newaetech/chipwhisperer-husky-fpga/README.md

# ChipWhisperer-Husky
This repository contains the FPGA design and test files for
ChipWhisperer-Husky and Husky-Plus.

# Documentation
All documentation is now on the associated
[readthedocs](https://chipwhisperer-husky-fpga.readthedocs.io) site.
