newaetech/chipwhisperer-husky-fpga/fpga/vivado/cw310/README.md

For exploring Husky on the much larger xc7k160tfbg676-1 FPGA, using the CW-310
Bergen board. Work in progress.
