newaetech/chipwhisperer-husky-fpga/docs/source/Testing/testing.md

# Overview

CW-Husky is tested in two ways:
1. [Verilog simulation](simulation)
2. [On-target testing](ontarget)
