newaetech/chipwhisperer-husky-fpga/(threads)

Thread 6 (2022-11-01):

Triggering glitch from SAD, UART, edge count, trace, or ADC level

jpcrypt, 2022-11-01:
When using the SAD, UART, edge count, trace, or ADC level as a trigger for glitching (i.e. `scope.glitch.trigger_src` is set to `ext_single` or `ext_continuous`), glitches are not always generated.

There are no known issues with triggering an **ADC capture** from these triggers - only in their use for glitching.

Credit to [Lennert Wouters](https://twitter.com/LennertWo) for finding the issue.

Closed 2022-11-05.

Thread 9 (2022-11-05):

Programmable pattern length for UART triggering.

jpcrypt, 2022-11-05:
The pattern length for UART (and trace) triggering is currently fixed at 8 bytes.
That is, if you set a pattern match as follows:
`scope.UARTTrigger.set_pattern_match(0, 'p00')`
then the trigger will not fire until Husky sees `p`, `0`, `0`, *and 5 more valid bytes* (which could be anything).
If Husky only sees `p00` followed by silence, then it won't trigger.
(Rationale: this made sense for trace since trace messages are always longer (if I remember correctly!))
For generic UART, it would be useful to  specify the pattern length; in the example above, if the length was set to 3, then Husky would fire a trigger immediately after seeing `p00`.

jpcrypt, 2023-01-31:
Important to note that the fix is not backwards compatible. The new default behaviour is that calling `set_pattern_match()` with a pattern shorter than 8 bytes will result in triggering immediately after the short pattern (instead of after the pattern + remaining bytes required to add up to 8 bytes).
If you were using something like `set_pattern_match(0, 'p00')` before and wish to retain the old behaviour, you'll need to change it to:
`set_pattern_match(0, 'p00xxxxx', [255,255,255,0,0,0,0,0])`.

Closed 2023-01-31.

Thread 16 (2023-07-28):

Capture triggering stuck

jpcrypt, 2023-07-28:
When multiple triggers are generated over the course of a capture (either from the target, or by a Husky trigger module like SAD), and `scope.adc.offset` is non-zero, unlucky combinations of ADC capture parameters and trigger events can result in the trigger module getting stuck: subsequent captures will fail with this message:

> (ChipWhisperer Scope WARNING|File _OpenADCInterface.py:623) Timeout in OpenADC capture(), no trigger seen! Trigger forced, data is invalid. Status: 10
WARNING:root:Timeout happened during capture

even though the trigger events are occurring. A full reset of Husky is then required to get functioning captures again.

Some conditions have to be met in order for the bug to pop up:
1. multiple triggers must occur during the capture of a *single* segment (e.g., `scope.adc.samples = X` and a trigger event occurs every < X samples This is not a normal setup for segmented capture.
2. `scope.adc.offset` must be greater than 0 (the greater it is, the more likely the bug will be triggered).
3. The ADC capture must finish in the window where a trigger has come in and the offset counter kicked off by that trigger has not reached `scope.adc.offset` yet.

This sounds complicated but what it boils down to is that you don't need to worry about this bug unless you have `scope.adc.segments=1`, `scope.adc.offset > 0`, and multiple trigger events during your capture, where the first trigger kicks off the capture and subsequent ones are ignored since `scope.adc.segments = 1`.

A fix is forthcoming.

jpcrypt, 2023-07-28:
Fixed by https://github.com/newaetech/chipwhisperer-husky-fpga/commit/c20c94b082bc7ecf07794f61588cc73470cedbcb

Closed 2023-07-28.

Thread 17 (2023-10-13):

Streaming can fail at low sampling rates

jpcrypt, 2023-10-13:
Streaming captures can fail with "slow FIFO underflow" and "fast FIFO overflow" errors when the sampling clock is < 10 MHz.

The failure occurs because the [Xilinx FIFO](https://github.com/newaetech/chipwhisperer-husky-fpga/tree/main/fpga/vivado/cwhusky.srcs/sources_1/ip/usb_slow_fifo)  (from which ADC samples are read) declares an underflow when it is actually nowhere near empty (internal FIFO read/write counters show that it's well over half full).

The reason *seems* to be that this FIFO was configured with a read clock of 96 MHz (which is accurate) and a write clock of 200 MHz (which is the fastest possible write clock, but could actually be as low as 5 MHz); it appears that the FIFO can misbehave when its read/write clock ratio is "too different" from what was specified.

A fix is in the works.

In the meantime there are workarounds:

- The simplest workaround is to simply increase the ADC sampling clock to 10 MHz or more. [Extensive testing](https://github.com/newaetech/chipwhisperer/blob/78fbca0326cb218c3e30ef11ff260aa1b01c9531/tests/test_husky.py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) has been done at those sampling rates; additionally, the [micro-ecc notebook series](https://github.com/newaetech/chipwhisperer-jupyter/tree/master/courses/sca205) does streaming captures at 10 MHz, and the [CW305 ECC series](https://github.com/newaetech/chipwhisperer-jupyter/tree/master/courses/sca204) uses 15 MHz.
- The next simplest  workaround is to increase the ADC sampling frequency by increasing `scope.clock.adc_mul`. This results in larger traces, but allows the target clock to stay the same.
- Another option involves tweaking the `scope.adc.stream_segment_size` and `scope.adc.stream_segment_threshold` parameters. These dictate the burst read size and default to 65536; reduce them (keeping both settings equal) until you get a clean capture. 8192 seems to work well with a sampling clock from 5 MHz to 9 MHz.

Closed 2023-10-16.
