newaetech/chipwhisperer-husky-fpga/fpga/hdl/fifo_top_husky_pro.v

`include "includes.v"
`timescale 1 ns / 1 ps
`default_nettype none

/***********************************************************************
This file is part of the ChipWhisperer Project. See www.newae.com for more
details, or the codebase at http://www.chipwhisperer.com
Built from fifo_top_husky.v and modified for Pro.

Copyright (c) 2021-2022, NewAE Technology Inc. All rights reserved.
Author: Jean-Pierre Thibault <jpthibault@newae.com>

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
  You should have received a copy of the GNU General Public License
  along with chipwhisperer.  If not, see <http://www.gnu.org/licenses/>.
*************************************************************************/

module fifo_top_husky_pro (
    input wire          reset,
    input wire          clk_usb,

    //ADC Sample Input
    input wire [11:0]   adc_datain,
    input wire          adc_sampleclk,
    input wire          capture_active, //for debug only
    input wire          capture_go,
    output reg          adc_capture_stop,
    input wire          arm_i,
    input wire          arm_usb,
    input wire [15:0]   num_segments,
    input wire [19:0]   segment_cycles,
    input wire          segment_cycle_counter_en,

    input wire  [14:0]  presample_i,
    input wire  [31:0]  max_samples_i,
    output wire [31:0]  max_samples_o,
    input wire  [12:0]  downsample_i, //Ignores this many samples inbetween captured measurements

    output wire         fifo_overflow, //If overflow happens (bad during stream mode)
    output reg          error_flag,
    output reg [13:0]   error_stat,
    output reg [13:0]   first_error_stat,
    output reg [2:0]    first_error_state,
    input  wire         clear_fifo_errors,
    input  wire         trigger_too_soon,
    input  wire         no_clip_errors,
    input  wire         no_gain_errors,
    output reg [7:0]    underflow_count,
    output reg          capture_done,
    output reg          armed_and_ready,
    output reg [2:0]    state,

    // to/from DDR:
    input  wire         ui_clk,
    output wire         capture_go_ui,
    output reg          write_done_out,
    input  wire         I_preddr_fifo_rd,
    output wire [63:0]  preddr_fifo_dout,
    output wire         preddr_fifo_empty,
    output reg          flushing,
    output wire         fast_fifo_empty,

    input  wire         postddr_fifo_empty,
    input  wire         postddr_fifo_overflow,
    input  wire         postddr_fifo_underflow_masked,
    input  wire         reading_too_soon_error,
    input  wire         ddr_full_error,

    output wire         arm_pulse_usb,

    input  wire         ddr_rwtest_en,

    input  wire         preddr_la_empty,
    input  wire         preddr_trace_empty,

    // for debug only:
    output reg          preddr_fifo_wr,
    output wire         preddr_fifo_underflow,
    output wire [7:0]   debug

);

    parameter pFIFO_FULL_SIZE = `MAX_SAMPLES;

    wire                fast_fifo_wr;
    reg                 fast_fifo_presample_drain;
    reg                 fast_fifo_rd_en = 1'b0;
    wire                fast_fifo_rd;
    wire [11:0]         fast_fifo_dout;
    wire                fast_fifo_full;
    wire                fast_fifo_overflow;
    wire                fast_fifo_underflow;

    reg                 preddr_fifo_rd_slow;
    wire                preddr_fifo_rd_fast;
    reg  [63:0]         preddr_fifo_din;
    wire                preddr_fifo_full;
    wire                preddr_fifo_overflow;

    reg                 fast_fifo_overflow_reg;
    reg                 preddr_fifo_overflow_reg;
    reg  [14:0]         presample_counter;
    reg  [31:0]         sample_counter;
    reg  [15:0]         segment_counter;
    reg  [19:0]         segment_cycle_counter;

    reg                 arm_r;
    wire                arm_pulse_adc;
    reg                 arming;
    reg                 capture_go_r;
    reg                 capture_go_r2;

    reg  [4:0]          done_wait_count;
    reg                 gain_error;
    reg                 segment_error;
    reg                 clip_error;
    reg                 gain_too_low;
    reg                 downsample_error;
    wire                clear_fifo_errors_adc;

    wire                write_done_ui;
    reg                 done_hold;

    assign fifo_overflow = fast_fifo_overflow_reg || preddr_fifo_overflow_reg;

    // make overflow sticky:
    always @(posedge adc_sampleclk) begin
       if (arm_pulse_adc || clear_fifo_errors_adc) begin
          fast_fifo_overflow_reg <= 1'b0;
          preddr_fifo_overflow_reg <= 1'b0;
       end
       else begin
          if (fast_fifo_overflow)
             fast_fifo_overflow_reg <= 1'b1;
          if (preddr_fifo_overflow)
             preddr_fifo_overflow_reg <= 1'b1;
       end
    end

    //Counter for downsampling (NOT proper decimation)
    reg [12:0] downsample_ctr;
    wire downsample_max;
    reg downsample_wr_en;

    assign downsample_max = (downsample_ctr == downsample_i) ? 1'b1 : 'b0;

    always @(posedge adc_sampleclk) begin
       if (arm_pulse_adc == 1'b1) begin
          downsample_ctr <= 13'd0;
          downsample_wr_en <= 1'b0;
       end 
       else begin
          // NOTE: capture_go_r* condition is to align downsample captures on
          // the trigger event. If downsample+presample support gets added,
          // this condition makes it possible to have two successive writes
          // that are very close together.
          if (downsample_max || (capture_go_r && ~capture_go_r2)) begin
             downsample_ctr <= 13'd0;
             downsample_wr_en <= 1'b1;
          end
          else begin
             downsample_ctr <= downsample_ctr + 13'd1;
             downsample_wr_en <= 1'b0;
          end
       end
    end

    assign max_samples_o = pFIFO_FULL_SIZE;


    // Presample logic: when armed, we always write to the fast FIFO. When
    // we reach the requested number of presamples, we start to also read
    // and discard, so as to keep exactly the requested number of presamples
    // in the fast FIFO. During this time, no data is sent to the slow FIFO.
    // When the trigger is received, the fast FIFO read data is then written
    // to the slow FIFO.

    localparam pS_IDLE = 0;
    localparam pS_PRESAMP_FILLING = 1;
    localparam pS_PRESAMP_FULL = 2;
    localparam pS_TRIGGERED = 3;
    localparam pS_SEGMENT_DONE = 4;
    localparam pS_DONE = 5;
    reg [2:0] state_r;

    // for easier debugging; also used by testbench:
    wire state_idle = (state == pS_IDLE);
    wire state_presamp_filling = (state == pS_PRESAMP_FILLING);
    wire state_presamp_full = (state == pS_PRESAMP_FULL);
    wire state_triggered = (state == pS_TRIGGERED);
    wire state_segment_done = (state == pS_SEGMENT_DONE);
    wire state_done = (state == pS_DONE);

    wire stop_capture_conditions;
    reg fsm_fast_wr_en;
    reg [19:0] segment_cycles_adjusted;

    assign stop_capture_conditions = arm_pulse_adc || adc_capture_stop;

    reg  presamp_done1_r;
    wire presamp_done1 = (capture_go && (segment_counter == 0));
    wire next_segment_go_pre = segment_cycle_counter_en?  ((segment_cycle_counter == segment_cycles_adjusted) && (segment_cycles > 0)) :
                                                          (capture_go && ~capture_go_r);

    wire presamp_done = presamp_done1_r || next_segment_go;
    wire presamp_error = presamp_done && (state == pS_PRESAMP_FILLING);

    reg next_segment_go;
    reg last_segment;
    reg last_sample;
    reg filler_read;
    // We're storing 12-bit samples into 64-bit words. If the number of samples is not a multiple of 
    // 16 (because 16 is the smallest number x such that x*12 is a number that can be divided by 64), 
    // then we need to execute dummy/filler ADC reads to fill out the last incomplete 64-bit word.
    wire [31:0] total_samples = max_samples_i * num_segments;
    wire filler_read_needed = (total_samples[3:0] != 4'b0000);

    always @(posedge adc_sampleclk) begin
        if (segment_cycles > 1) // alternatively, could do this in Python instead  (but why- everything works now)
            segment_cycles_adjusted <= segment_cycles - 2;
        else
            segment_cycles_adjusted <= segment_cycles;
        next_segment_go <= next_segment_go_pre; // this would add a cycle of latency but we've compensate by registering the ADC input in openadc_interface.v
        last_segment <= (segment_counter == (num_segments-1));
        if (downsample_i > 0)
            last_sample <= (sample_counter == (max_samples_i-1));
        else
            last_sample <= (sample_counter == (max_samples_i-2));
        presamp_done1_r <= presamp_done1;
    end

    always @ (posedge adc_sampleclk) begin
        if (reset) begin
            clip_error <= 1'b0;
            gain_too_low <= 1'b0;
            gain_error <= 1'b0;
        end
        else begin
            if (no_clip_errors || clear_fifo_errors_adc)
                clip_error <= 1'b0;
            //  TODO: just condition on "ADC fifo out when triggered" sort of thing
            else if (preddr_fifo_wr && (fast_fifo_dout[11:0]  == {12{1'b1}} || fast_fifo_dout[11:0]  == {12{1'b0}}) )
                clip_error <= 1'b1;

            if (no_gain_errors || clear_fifo_errors_adc)
                gain_too_low <= 1'b0;
            else if (capture_go)
                gain_too_low <= 1'b1;
            else if (preddr_fifo_wr && (fast_fifo_dout[11]? fast_fifo_dout[10:9]  != 2'b00 : fast_fifo_dout[10:8]  != 3'b111) )
                gain_too_low <= 1'b0;

            if (no_gain_errors || clear_fifo_errors_adc)
                gain_error <= 1'b0;
            else if ((state == pS_IDLE) && (state_r == pS_DONE) && gain_too_low)
                gain_error <= 1'b1;
        end
    end

    always @ (posedge adc_sampleclk) begin
       if (reset) begin
          state <= pS_IDLE;
          presample_counter <= 0;
          sample_counter <= 0;
          fast_fifo_presample_drain <= 1'b0;
          adc_capture_stop <= 1'b0;
          fast_fifo_rd_en <= 1'b0;
          segment_counter <= 0;
          segment_cycle_counter <= 0;
          downsample_error <= 1'b0;
          segment_error <= 1'b0;
          filler_read <= 1'b0;
       end

       else begin
          state_r <= state;
          case (state)

             pS_IDLE: begin
                presample_counter <= 0;
                sample_counter <= 0;
                fast_fifo_presample_drain <= 1'b0;
                adc_capture_stop <= 1'b0;
                fast_fifo_rd_en <= 1'b0;
                segment_counter <= 0;
                segment_cycle_counter <= 0;
                segment_error <= 1'b0;
                fsm_fast_wr_en <= 1'b0;
                filler_read <= 1'b0;
                done_wait_count <= 0;

                if ((downsample_i > 0) && ((presample_i > 0) || (num_segments > 1)))
                   downsample_error <= 1'b1;
                else
                   downsample_error <= 1'b0;

                if (armed_and_ready && ~adc_capture_stop && ~ddr_rwtest_en) begin
                   if (presample_i > 0) begin
                      fsm_fast_wr_en <= 1'b1;
                      state <= pS_PRESAMP_FILLING;
                   end
                   else if (capture_go_r) begin
                      fsm_fast_wr_en <= 1'b1;
                      state <= pS_TRIGGERED;
                   end
                end
             end

             pS_PRESAMP_FILLING: begin
                fast_fifo_presample_drain <= 1'b0;
                if (next_segment_go && (state_r == pS_PRESAMP_FILLING))
                   segment_error <= 1'b1;
                if (segment_counter > 0)
                   segment_cycle_counter <= segment_cycle_counter + 1;
                if (stop_capture_conditions) begin
                   fsm_fast_wr_en <= 1'b0;
                   state <= pS_DONE;
                end
                else if (presamp_done) begin
                   state <= pS_TRIGGERED;
                end
                else if (presample_counter == (presample_i-2)) begin
                   state <= pS_PRESAMP_FULL;
                end
                else if (fast_fifo_wr) begin
                   presample_counter <= presample_counter + 1;
                end
             end

             pS_PRESAMP_FULL: begin
                if (segment_counter > 0)
                   segment_cycle_counter <= segment_cycle_counter + 1;
                if (stop_capture_conditions) begin
                   fsm_fast_wr_en <= 1'b0;
                   state <= pS_DONE;
                end
                else if (presamp_done) begin
                   segment_cycle_counter <= 0;
                   sample_counter <= {17'b0, presample_i};
                   state <= pS_TRIGGERED;
                end
                if (fast_fifo_wr)
                   fast_fifo_presample_drain <= 1'b1;
                else
                   fast_fifo_presample_drain <= 1'b0;
             end

             pS_TRIGGERED: begin
                if (next_segment_go && (state_r == pS_TRIGGERED))
                   segment_error <= 1'b1;
                fast_fifo_presample_drain <= 1'b0;
                fast_fifo_rd_en <= 1'b1;
                segment_cycle_counter <= segment_cycle_counter + 1;

                if (stop_capture_conditions || (last_sample && fast_fifo_wr && last_segment)) begin
                   adc_capture_stop <= 1'b1;
                   done_wait_count <= 20;  // established by trial/error to account for the latency in the Xilinx FIFO updating its empty flag
                                           // plus extra cycles to execute filler_read (to generate the last 64-bit word)
                                           // TODO: update to 20 for Pro needs to be more carefully checked; it was chosen because it looked like
                                           // it should work.
                   fsm_fast_wr_en <= 1'b0;
                   state <= pS_DONE;
                end

                else if (last_sample && ~last_segment && fast_fifo_wr) begin
                   fsm_fast_wr_en <= 1'b0;
                   state <= pS_SEGMENT_DONE;
                end

                if (fast_fifo_wr) begin
                   sample_counter <= sample_counter + 1;
                end
             end

             pS_SEGMENT_DONE: begin
                segment_cycle_counter <= segment_cycle_counter + 1;
                if (fast_fifo_empty) begin
                   fast_fifo_rd_en <= 1'b0;
                   if (presample_i > 0) begin
                      segment_counter <= segment_counter + 1;
                      sample_counter <= 0;
                      presample_counter <= 0;
                      fsm_fast_wr_en <= 1'b1;
                      state <= pS_PRESAMP_FILLING;
                   end
                   else if (next_segment_go) begin
                      segment_counter <= segment_counter + 1;
                      segment_cycle_counter <= 0;
                      sample_counter <= 0;
                      fsm_fast_wr_en <= 1'b1;
                      state <= pS_TRIGGERED;
                   end
                end
                else if (next_segment_go) begin
                   segment_error <= 1'b1;
                   state <= pS_IDLE;
                end
             end

             pS_DONE: begin
                // serves three purposes:
                // 1. wait for fast FIFO to empty;
                // 2. generate "filler reads" so that the last full 64-bit word of ADC samples can be formed
                // 3. wait state so that we don't get back out of idle right away
                if ((fast_fifo_empty && (done_wait_count == 0)) || arm_i) begin
                   fast_fifo_rd_en <= 1'b0;
                   state <= pS_IDLE;
                end
                else if (fast_fifo_empty && (~preddr_fifo_full || filler_read))
                   // logic for the filler_read condition above is that when we start the filler reads,
                   // we know there will be only a single preddr FIFO write and so we no longer need to check on
                   // it being full
                   done_wait_count <= done_wait_count - 1;

                if (filler_read_needed && (done_wait_count < 6)) // TODO: "5" is just a placeholder; need to calculate correct value here!
                   filler_read <= 1'b1;

             end

          endcase
       end
    end

    always @(posedge adc_sampleclk) begin
       if (arm_pulse_adc)
          capture_done <= 1'b0;
       else if (state == pS_DONE)
          capture_done <= 1'b1;
    end


   wire clear_fifo_errors_r2;
   assign clear_fifo_errors_adc = clear_fifo_errors_r2;
   cdc_simple U_clear_fifo_errors_cdc (
       .reset          (reset),
       .clk            (adc_sampleclk),
       .data_in        (clear_fifo_errors),
       .data_out       (),
       .data_out_r     (clear_fifo_errors_r2)
   );

   wire flushing_adc;
   cdc_simple U_flushing_adc_cdc (
       .reset          (reset),
       .clk            (adc_sampleclk),
       .data_in        (flushing),
       .data_out       (flushing_adc),
       .data_out_r     ()
   );

   wire flushing_adc_usb;
   cdc_simple U_flushing_adc_usb_cdc (
       .reset          (reset),
       .clk            (clk_usb),
       .data_in        (flushing_adc),
       .data_out       (flushing_adc_usb),
       .data_out_r     ()
   );

   wire flushing_ui_usb;
   cdc_simple U_flushing_ui_usb_cdc (
       .reset          (reset),
       .clk            (clk_usb),
       .data_in        (flushing_ui),
       .data_out       (flushing_ui_usb),
       .data_out_r     ()
   );



    always @(posedge adc_sampleclk) begin
       if (reset) begin
          arming <= 1'b0;
          armed_and_ready <= 1'b0;
          capture_go_r <= 1'b0;
          capture_go_r2 <= 1'b0;
       end
       else begin
          capture_go_r <= capture_go;
          capture_go_r2 <= capture_go_r;
          arm_r <= arm_i;
          if (arm_i && ~arm_r && ~arming) begin
             arming <= 1'b1;
             armed_and_ready <= 1'b0;
          end
          else if (arming && ~flushing_adc) begin       // Thread carefully with this logic; the risk is that flushing_adc hasn't gone high yet
                                                        // before this condition is satisfied (and hence flushing hasn't even begun. Two clock
                                                        // domains are involved so exsercise caution.
             arming <= 1'b0;
             armed_and_ready <= 1'b1;
          end
          else if (adc_capture_stop)
             armed_and_ready <= 1'b0;
       end
    end

    assign fast_fifo_wr = downsample_wr_en & fsm_fast_wr_en & ~flushing_adc;

    // FIFO flushing mechanism: kick off flushing all FIFOs when arming.
    // Controlled from USB clock domain since that's closest to the ARM event,
    // and FIFOs use all the clocks anyways. Complicated only by all the
    // clocks.

    wire fast_fifo_empty_usb;
    cdc_simple U_fast_fifo_empty_cdc (
        .reset          (reset),
        .clk            (clk_usb),
        .data_in        (fast_fifo_empty),
        .data_out       (fast_fifo_empty_usb),
        .data_out_r     ()
    );

    // TODO: not needed?
    wire all_preddr_fifo_empty_usb;
    cdc_simple U_all_preddr_fifo_empty_cdc (
        .reset          (reset),
        .clk            (clk_usb),
        .data_in        (all_preddr_fifo_empty),
        .data_out       (all_preddr_fifo_empty_usb),
        .data_out_r     ()
    );

    // NOTE: the FIFO flush from arming the scope does not connect to the LA or trace preddr FIFOs, since trace and LA
    // have their own arming mechanisms; this *should* be fine since their preddr FIFOs will report "empty" when not enabled.
    // NOTE2: this would cause DUT to hang-up if an ADC job comes in when LA
    // job has already begun (thanks cocotb!). I think it's fine to just
    // remove it, but leaving these notes in case this somehow causes an
    // issue, for some reason I can't think of right now... TODO: eventually
    // clean up!
    wire all_preddr_fifo_empty = preddr_fifo_empty && preddr_la_empty && preddr_trace_empty;

    reg arm_usb_r;
    assign arm_pulse_usb = arm_usb && ~arm_usb_r;
    always @(posedge clk_usb) begin
        if (reset) begin
            flushing <= 1'b0;
            arm_usb_r <= 1'b0;
        end
        else begin
            arm_usb_r <= arm_usb;
            if (arm_pulse_usb)
                flushing <= 1'b1;
            //else if (fast_fifo_empty_usb && all_preddr_fifo_empty_usb && postddr_fifo_empty)
            // last two conditions are to ensure that CDC from flushing to flushing_adc and flushing_ui had a chance to occur:
            else if (fast_fifo_empty_usb && postddr_fifo_empty && flushing_adc_usb && flushing_ui_usb)
                flushing <= 1'b0;
        end
    end

    cdc_pulse U_fifo_rst_start_cdc (
       .reset_i       (reset),
       .src_clk       (clk_usb),
       .src_pulse     (arm_pulse_usb),
       .dst_clk       (adc_sampleclk),
       .dst_pulse     (arm_pulse_adc)
    );

    wire flushing_ui;
    cdc_simple U_flushing_ui_cdc (
        .reset          (reset),
        .clk            (ui_clk),
        .data_in        (flushing),
        .data_out       (flushing_ui),
        .data_out_r     ()
    );


    wire postddr_fifo_underflow_masked_adc;
    cdc_simple U_slow_fifo_underflow_masked_cdc (
        .reset          (reset),
        .clk            (clk_usb),
        .data_in        (postddr_fifo_underflow_masked),
        .data_out       (postddr_fifo_underflow_masked_adc),
        .data_out_r     ()
    );

    // this may seem awkward; goal is to set new error bits without clearing old ones
    function [13:0] error_bits (input [13:0] current_error);
       begin
          error_bits = current_error;
          if (ddr_full_error)                error_bits[13] = 1'b1;
          if (reading_too_soon_error)        error_bits[12] = 1'b1;
          if (preddr_fifo_overflow)          error_bits[11] = 1'b1;
          if (preddr_fifo_underflow)         error_bits[10] = 1'b1;
          if (trigger_too_soon)              error_bits[9]  = 1'b1;
          if (gain_error)                    error_bits[8]  = 1'b1;
          if (segment_error)                 error_bits[7]  = 1'b1;
          if (downsample_error)              error_bits[6]  = 1'b1;
          if (clip_error)                    error_bits[5]  = 1'b1;
          if (presamp_error)                 error_bits[4]  = 1'b1;
          if (fast_fifo_overflow)            error_bits[3]  = 1'b1;
          if (fast_fifo_underflow)           error_bits[2]  = 1'b1;
          if (postddr_fifo_overflow)         error_bits[1]  = 1'b1;
          if (postddr_fifo_underflow_masked_adc) error_bits[0]  = 1'b1;
       end
    endfunction

    always @(posedge adc_sampleclk) begin
       if (reset) begin
          error_flag <= 0;
          error_stat <= 0;
          first_error_stat <= 0;
          underflow_count <= 0;
          first_error_state <= pS_IDLE;
       end
       else begin
          if (arm_pulse_adc || clear_fifo_errors) begin
             error_stat <= 0;
             first_error_stat <= 0;
             error_flag <= 0;
             underflow_count <= 0;
             first_error_state <= pS_IDLE;
          end
          else begin
             if (gain_error || segment_error || downsample_error || clip_error || presamp_error || 
                 fast_fifo_overflow || fast_fifo_underflow || postddr_fifo_overflow || postddr_fifo_underflow_masked_adc || 
                 preddr_fifo_overflow || preddr_fifo_underflow || reading_too_soon_error || ddr_full_error) begin
                error_flag <= 1;
                if (!error_flag) begin
                   first_error_stat <= error_bits(first_error_stat);
                   first_error_state <= state_r;
                end
             end

             error_stat <= error_bits(error_stat);

             if (postddr_fifo_underflow_masked_adc && (underflow_count != 8'hFF))
                underflow_count <= underflow_count + 1;
          end
       end
    end


    // Assemble 64-bit words from 12-bit samples to feed DDR.
    // Ideally we'd handle this with an asymetric+asynchronous FIFO, but Xilinx's simulation
    // model for such FIFOs doesn't simulate with iVerilog :-(
    // So this is the width conversion stage, which is followed by an asynchronous FIFO.
    // *must* be able to push one sample per cycle, to keep up.
    // But if decimation is used, then data will come in slower; must accomodate that too.
    // Word 1: 6 sample reads; 5x12, 4
    // Word 2: 5 sample reads; 8, 4x12, 8
    // Word 3: 5 sample reads; 4, 5x12
    // then start over...
    reg [1:0] wide_word_count;
    reg wide_word_valid;
    reg [71:0] wide_word_shifter;
    reg [2:0] adc_sample_counter;

    always @(posedge adc_sampleclk) begin
        if (reset) begin
            wide_word_count <= 0;
            wide_word_valid <= 0;
            wide_word_shifter <= 0;
            adc_sample_counter <= 0;
            preddr_fifo_din <= 0;
            preddr_fifo_wr <= 0;
            filler_write <= 0;
        end
        else begin
            preddr_fifo_wr <= wide_word_valid;
            filler_write <= wide_word_valid && filler_read;
            if (state == pS_IDLE) begin
                wide_word_count <= 0;
                wide_word_valid <= 0;
                wide_word_shifter <= 0;
                adc_sample_counter <= 0;
            end
            else if ((fast_fifo_rd || filler_read) && (state != pS_PRESAMP_FILLING) && (state != pS_PRESAMP_FULL)) begin
                wide_word_shifter <= {wide_word_shifter[59:0], fast_fifo_dout};
                if ( ((wide_word_count == 0) && (adc_sample_counter == 5)) ||
                     ((wide_word_count == 1) && (adc_sample_counter == 4)) ||
                     ((wide_word_count == 2) && (adc_sample_counter == 4)) ) begin
                    wide_word_valid <= 1'b1;
                    adc_sample_counter <= 0;
                    if (wide_word_count < 2)
                        wide_word_count <= wide_word_count + 1;
                    else
                        wide_word_count <= 0;
                end
                else begin
                    wide_word_valid <= 0;
                    adc_sample_counter <= adc_sample_counter + 1;
                end
            end
            else if (~filler_read)
                wide_word_valid <= 0;

            if (wide_word_valid)
                preddr_fifo_din <= (wide_word_count == 1)? wide_word_shifter[71:8] :
                                   (wide_word_count == 2)? wide_word_shifter[67:4] :
                                                           wide_word_shifter[63:0] ;
        end
    end

    reg filler_write;
    reg  write_done_adc;

    always @ (*) begin
        if (filler_read_needed)
            write_done_adc = filler_write;
        else
            write_done_adc = (state == pS_IDLE) && (state_r == pS_DONE);
    end

    cdc_pulse U_write_done_cdc (
       .reset_i       (reset),
       .src_clk       (adc_sampleclk),
       .src_pulse     (write_done_adc),
       .dst_clk       (ui_clk),
       .dst_pulse     (write_done_ui)
    );

    cdc_pulse U_capture_go_cdc (
       .reset_i       (reset),
       .src_clk       (adc_sampleclk),
       .src_pulse     (capture_go_r && ~capture_go_r2),
       .dst_clk       (ui_clk),
       .dst_pulse     (capture_go_ui)
    );

    always @(posedge ui_clk) begin
        if (reset) begin
            done_hold <= 1'b0;
            write_done_out <= 1'b0;
        end
        else begin
            // The write_done pulse activates a hold signal; then when the FIFO
            // goes empty, we know we are done:
            if (write_done_ui)
                done_hold <= 1'b1;
            else if (write_done_out)
                write_done_out <= 1'b0;
            else if (done_hold && preddr_fifo_empty) begin
                write_done_out <= 1'b1;
                done_hold <= 1'b0;
            end
        end
    end

    assign fast_fifo_rd = fast_fifo_presample_drain || 
                          (fast_fifo_rd_en && !preddr_fifo_full && !fast_fifo_empty) || 
                          (flushing_adc && !fast_fifo_empty);

    wire preddr_fifo_rd = I_preddr_fifo_rd || (flushing_ui && !preddr_fifo_empty);


    `ifdef NOXILINXFIFO
        `ifdef TINYFIFO
            // Note: can't use pBRAM on U_adc_fast_fifo because it would lead
            // to writing and reading the same memory location simultaneously.
            // This could be addressed by changing the FSM R/W timings.
            fifo_sync #(
                .pDATA_WIDTH    (12),
                .pDEPTH         (1024),
                .pFALLTHROUGH   (1),
                .pFLOPS         (0),
                .pDISTRIBUTED   (1),
                .pBRAM          (0)
            ) U_adc_fast_fifo (
                .clk            (adc_sampleclk),
                .rst_n          (~reset),
                .full_threshold_value (0),
                .empty_threshold_value (0),
                .wen            (fast_fifo_wr),
                .wdata          (adc_datain),
                .full           (fast_fifo_full),
                .overflow       (fast_fifo_overflow),
                .full_threshold (),
                .empty_threshold(),
                .ren            (fast_fifo_rd),
                .rdata          (fast_fifo_dout),
                .empty          (fast_fifo_empty),
                .almost_empty   (),
                .almost_full    (),
                .underflow      (fast_fifo_underflow)
            );
        `else
            fifo_sync #(
                .pDATA_WIDTH    (12),
                .pDEPTH         (32768),
                .pFALLTHROUGH   (1),
                .pFLOPS         (0),
                .pDISTRIBUTED   (1),
                .pBRAM          (0)
            ) U_adc_fast_fifo (
                .clk            (adc_sampleclk),
                .rst_n          (~reset),
                .full_threshold_value (0),
                .empty_threshold_value (0),
                .wen            (fast_fifo_wr),
                .wdata          (adc_datain),
                .full           (fast_fifo_full),
                .overflow       (fast_fifo_overflow),
                .full_threshold (),
                .empty_threshold(),
                .ren            (fast_fifo_rd),
                .rdata          (fast_fifo_dout),
                .empty          (fast_fifo_empty),
                .almost_empty   (),
                .almost_full    (),
                .underflow      (fast_fifo_underflow)
            );
        `endif
        fifo_async #(
            .pDATA_WIDTH    (64),
            .pDEPTH         (512),
            .pFALLTHROUGH   (0),
            .pFLOPS         (0),
            .pDISTRIBUTED   (0),
            .pBRAM          (1)
        ) U_pre_ddr_slow_fifo (
            .wclk                   (adc_sampleclk),
            .rclk                   (ui_clk),
            .wrst_n                 (~reset),
            .rrst_n                 (~reset),
            .wfull_threshold_value  (0),
            .rempty_threshold_value (0),
            .wen                    (preddr_fifo_wr),
            .wdata                  (preddr_fifo_din),
            .wfull                  (preddr_fifo_full),
            .walmost_full           (),
            .woverflow              (preddr_fifo_overflow),
            .wfull_threshold        (),
            .ren                    (preddr_fifo_rd),
            .rdata                  (preddr_fifo_dout),
            .rempty                 (preddr_fifo_empty),
            .ralmost_empty          (),
            .rempty_threshold       (),
            .runderflow             (preddr_fifo_underflow)
        );

    `else
        `ifdef TINYFIFO
           //for faster corner case simulation
           tiny_adc_fast_fifo U_adc_fast_fifo(
              .clk          (adc_sampleclk),
              .rst          (reset),
              .din          (adc_datain),
              .wr_en        (fast_fifo_wr),
              .rd_en        (fast_fifo_rd),
              .dout         (fast_fifo_dout),
              .full         (fast_fifo_full),
              .empty        (fast_fifo_empty),
              .overflow     (fast_fifo_overflow),
              .underflow    (fast_fifo_underflow)
           );
        `else
           //normal case
           adc_fast_fifo U_adc_fast_fifo (
              .clk          (adc_sampleclk),
              .rst          (reset),
              .din          (adc_datain),
              .wr_en        (fast_fifo_wr),
              .rd_en        (fast_fifo_rd),
              .dout         (fast_fifo_dout),
              .full         (fast_fifo_full),
              .empty        (fast_fifo_empty),
              .overflow     (fast_fifo_overflow),
              .underflow    (fast_fifo_underflow)
           );
        `endif
        pre_ddr_slow_fifo U_pre_ddr_slow_fifo (
           .rst          (reset),
           .wr_clk       (adc_sampleclk),
           .rd_clk       (ui_clk),
           .din          (preddr_fifo_din),
           .wr_en        (preddr_fifo_wr),
           .rd_en        (preddr_fifo_rd),
           .dout         (preddr_fifo_dout),
           .full         (preddr_fifo_full),
           .empty        (preddr_fifo_empty),
           .overflow     (preddr_fifo_overflow),
           .underflow    (preddr_fifo_underflow)
        );

    `endif


   assign debug = {adc_capture_stop,
                   reset,
                   armed_and_ready,
                   arming,
                   capture_go,
                   state};

`ifdef ILA_HUSKY_FIFO
    ila_fast_fifo U_ila_fast_fifo (
        .clk            (adc_sampleclk),        // input wire clk
        .probe0         (reset),                // input wire [0:0]  probe0  
        .probe1         (fast_fifo_wr),         // input wire [0:0]  probe1 
        .probe2         (fast_fifo_rd),         // input wire [0:0]  probe2 
        .probe3         (fast_fifo_dout),       // input wire [11:0] probe3 
        .probe4         (fast_fifo_full),       // input wire [0:0]  probe4 
        .probe5         (fast_fifo_empty),      // input wire [0:0]  probe5 
        .probe6         (fast_fifo_overflow),   // input wire [0:0]  probe6 
        .probe7         (fast_fifo_underflow),  // input wire [0:0]  probe7 
        .probe8         (capture_active),       // input wire [0:0]  probe8 
        .probe9         (adc_capture_stop),     // input wire [0:0]  probe9 
        .probe10        (state),                // input wire [2:0]  probe10
        .probe11        (adc_datain),           // input wire [11:0] probe11
        .probe12        (preddr_fifo_wr),       // input wire [0:0]  probe12
        .probe13        (preddr_fifo_full),     // input wire [0:0]  probe13
        .probe14        (preddr_fifo_overflow), // input wire [0:0]  probe14
        .probe15        (error_stat),           // input wire [11:0] probe15
        .probe16        (error_flag),           // input wire [0:0]  probe16
        .probe17        (filler_read),          // input wire [0:0]  probe17
        .probe18        (filler_write),         // input wire [0:0]  probe18
        .probe19        (write_done_adc),       // input wire [0:0]  probe19
        .probe20        (adc_sample_counter),   // input wire [2:0]  probe20
        .probe21        (wide_word_valid),      // input wire [0:0]  probe21
        .probe22        (wide_word_shifter),    // input wire [71:0] probe22
        .probe23        (filler_read_needed),   // input wire [0:0]  probe23
        .probe24        (preddr_fifo_din)       // input wire [63:0] probe24
    );
`endif


endmodule
`default_nettype wire
