newaetech/chipwhisperer-husky-fpga/fpga/hdl/esad.v

`include "includes.v"
`timescale 1 ns / 1 ps
`default_nettype none

/***********************************************************************
This file is part of the ChipWhisperer Project. See www.newae.com for more
details, or the codebase at http://www.chipwhisperer.com

Copyright (c) 2024, NewAE Technology Inc. All rights reserved.
Author: Jean-Pierre Thibault <jpthibault@newae.com>

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
Implementation notes:
=====================
Compared to sad.v, we add pNUM_COUNTERS and use that to size relevant
components (instead of using pREF_SAMPLES as the number of reference samples
*and* the number of counters).

We add an "extended_mode" bit flag to each counter; when set, it means that
the associated counter is working on the extended set (second half) of
reference samples.

Each counter starts with extended_mode clear; at the halfway point,
a decision is made to either restart from ref sample 0 (if SAD is too high),
or keep going with the second half of the ref samples (and set
extended_mode to show that we're doing this).

Then, we use extended_mode to manage nextrefsample indexing.

Note extended_mode needs to be set a few cycles before the halfway point, due
to the latency in our SAD computations (i.e. if we wait until we have the
halfway point SAD result, it's too late because we've already started using
potentially wrong samples in our SAD pipeline).

Notes on instantiation parameters:
==================================
pREF_SAMPLES is the length of the SAD pattern (in extended mode); it can be
adjusted to control the size of the implementation. It must be a multiple of 2.

pSAD_COUNTER_WIDTH has no effect unless `INTERVAL_MATCHING is not set.
Otherwise, it controls the width of the SAD counters, and therefore limits the
maximum SAD that can be computed; it has a significant effect on size.

pNUM_GROUPS must divide pNUM_COUNTERS (which is pREF_SAMPLES/2) evenly. It has
no bearing on functionality but it can affect implementation results.

pBITS_PER_SAMPLE is the ADC sample size that is used for the SAD computation.
In theory this could be anything; in practice values != 8 have not been tested.

Other paramaters should not be touched.

*************************************************************************/

module esad #(
    parameter pBYTECNT_SIZE = 7,
    parameter pREF_SAMPLES = 32,
    parameter pBITS_PER_SAMPLE = 8,
    parameter pSAD_COUNTER_WIDTH = 16,
    parameter pNUM_GROUPS = 4
)(
    input wire          reset,
    input wire          xadc_error,

    //ADC Sample Input
    input wire [pBITS_PER_SAMPLE-1:0] adc_datain,
    input wire          adc_sampleclk,
    input wire          armed_and_ready,
    input wire          active,
    input wire          trigger_allowed,

    //USB register interface
    input wire          clk_usb,
    input  wire [7:0]   reg_address,  // Address of register
    input  wire [pBYTECNT_SIZE-1:0]  reg_bytecnt,  // Current byte count
    input  wire [7:0]   reg_datai,    // Data to write
    output reg  [7:0]   reg_datao,    // Data to read
    input  wire         reg_read,     // Read flag
    input  wire         reg_write,    // Write flag

    output wire [7:0]   sad_debug,

    // verilator lint_off UNUSED
    input  wire         ext_trigger,  // debug only
    input  wire         io4,  // debug only
    output wire [pREF_SAMPLES/2-1:0] debug_emode,
    // verilator lint_on UNUSED
    output reg          trigger
);

    localparam pNUM_COUNTERS = pREF_SAMPLES/2;
    localparam pMASTER_COUNTER_WIDTH = (pREF_SAMPLES <= 32)?  5 :
                                       (pREF_SAMPLES <= 64)?  6 :
                                       (pREF_SAMPLES <= 128)? 7 :
                                       (pREF_SAMPLES <= 256)? 8 :
                                       (pREF_SAMPLES <= 512)? 9 :
                                       (pREF_SAMPLES <= 1024)? 10 : 11;

    localparam pACTUAL_SAD_COUNTER_WIDTH = (`INTERVAL_MATCHING == 1)? (pMASTER_COUNTER_WIDTH-2) : pSAD_COUNTER_WIDTH;

    reg  triggered = 1'b0;
    reg [15:0] num_triggers;
    reg clear_status;
    reg clear_status_r;
    wire clear_status_adc;

    reg refsamples_wr = 1'b0;
    wire refsamples_overflow_error;
    wire refsamples_underflow_error;
    wire refsamples_empty;
    wire refsamples_rd;
    wire [pBITS_PER_SAMPLE-1:0] refsamples_dout;

    reg refen_wr = 1'b0;
    wire refen_overflow_error;
    wire refen_underflow_error;
    wire refen_empty;
    wire refen_rd;
    wire [7:0] refen_dout;


    reg always_armed;
    reg emode;
    reg multiple_triggers;
    reg [pREF_SAMPLES*pBITS_PER_SAMPLE-1:0] refsamples;
    reg [pREF_SAMPLES-1:0] refen = {pREF_SAMPLES{1'b1}}; // all samples enabled by default
    reg [pNUM_COUNTERS-1:0] compare_en, compare_en_short, compare_en_extended, compare_en_r;
    reg [pACTUAL_SAD_COUNTER_WIDTH-1:0] threshold;
    reg [pBITS_PER_SAMPLE-1:0] interval_threshold;      // NOTE: pBITS_PER_SAMPLE is assumed to be <= 8
    wire [pACTUAL_SAD_COUNTER_WIDTH-2:0] half_threshold = threshold[pACTUAL_SAD_COUNTER_WIDTH-1:1];
    reg [pMASTER_COUNTER_WIDTH-1:0] master_counter;
    wire [pMASTER_COUNTER_WIDTH-2:0] master_counter_short = master_counter[pMASTER_COUNTER_WIDTH-2:0];
    wire [pMASTER_COUNTER_WIDTH-1:0] master_counter_extended = {1'b1, master_counter_short};
    reg  [pMASTER_COUNTER_WIDTH-2:0] refsample_shift_count = 0;
    reg [pNUM_COUNTERS-1:0] resetter;
    reg [pNUM_COUNTERS-1:0] triggerer;
    reg [pMASTER_COUNTER_WIDTH-1:0] triggerer_init = pNUM_COUNTERS-3; 
    reg [pNUM_COUNTERS-1:0] halfpoint;
    reg [pNUM_COUNTERS-1:0] trigger_possible;
    reg [pNUM_COUNTERS-1:0] extended_mode = {pNUM_COUNTERS{1'b0}};

    reg individual_trigger [0:pREF_SAMPLES-1];
    reg individual_trigger_r [0:pREF_SAMPLES-1];
    reg [pACTUAL_SAD_COUNTER_WIDTH-1:0] sad_counter [0:pNUM_COUNTERS-1];
    reg [pBITS_PER_SAMPLE-1:0] counter_incr [0:pNUM_COUNTERS-1];

    reg  armed_and_ready_r;
    reg  armed_and_ready_sad;
    reg  sad_control_write;
    wire sad_control_write_adc;

    reg ready2trigger0;
    reg [pNUM_COUNTERS-1:1] ready2trigger_1andup;
    wire [pNUM_COUNTERS-1:0] ready2trigger_all = {ready2trigger_1andup, ready2trigger0};

    reg  decision [0:pNUM_COUNTERS-1];
    reg [pBITS_PER_SAMPLE-1:0]  nextrefsample [0:pNUM_COUNTERS-1];
    reg [pBITS_PER_SAMPLE-1:0]  nextrefsample_short [0:pNUM_COUNTERS-1];
    reg [pBITS_PER_SAMPLE-1:0]  nextrefsample_extended [0:pNUM_COUNTERS-1];
    reg [pBITS_PER_SAMPLE-1:0]  nextrefsample_r [0:pNUM_COUNTERS-1];
    wire [pBITS_PER_SAMPLE-1:0]  refsample [0:pREF_SAMPLES-1];
    reg [pBITS_PER_SAMPLE-1:0] adc_datain_rpr, adc_datain_rmr; // sign extend
    reg [pBITS_PER_SAMPLE-1:0] adc_datain_r;

`ifdef HIPERF
    wire [23:0] status_reg = 24'b0;
`else
    wire [23:0] status_reg = {num_triggers, refen_overflow_error, refen_underflow_error, refsamples_overflow_error, refsamples_underflow_error, 2'b0, shifter_active, triggered};
`endif

    wire [31:0] wide_threshold_reg = {{(32-pACTUAL_SAD_COUNTER_WIDTH){1'b0}}, threshold}; // having a variable-width register isn't very convenient for Python
    wire [15:0] ref_samples = pREF_SAMPLES;

    assign debug_emode = extended_mode | trigger_possible;

    // See sad.v for definitions:
    wire advanced_trigger_time_support = 1'b1;
    wire max_threshold = (`INTERVAL_MATCHING == 1)? 1'b1 : 1'b0;
    wire esad_support = 1'b1;
    wire im_support = 1'b1;
    wire [2:0] version = 3'b110;
    wire [4:0] latency = 5'd10;
    wire [11:0] version_bits = {advanced_trigger_time_support, max_threshold, esad_support, im_support, version, latency};

    // register reads:
    always @(*) begin
        if (reg_read) begin
            case (reg_address)
                `SAD_TRIGGER_TIME: reg_datao = triggerer_init[reg_bytecnt*8 +: 8];
                `SAD_THRESHOLD: reg_datao = wide_threshold_reg[reg_bytecnt*8 +: 8];
                `SAD_INTERVAL_THRESHOLD: reg_datao = interval_threshold;
                `SAD_STATUS: reg_datao = status_reg[reg_bytecnt*8 +: 8];
                `SAD_BITS_PER_SAMPLE: reg_datao = pBITS_PER_SAMPLE;
                `SAD_REF_SAMPLES: reg_datao = ref_samples[reg_bytecnt*8 +: 8];
                `SAD_COUNTER_WIDTH: reg_datao = pACTUAL_SAD_COUNTER_WIDTH;
                `SAD_CONTROL: reg_datao = {5'b0, emode, multiple_triggers, always_armed};
                `SAD_VERSION: reg_datao = version_bits[reg_bytecnt*8 +: 8];
                default: reg_datao = 0;
            endcase
        end
        else
            reg_datao = 0;
    end

    // register writes:
    always @(posedge clk_usb) begin
        if (reset) begin
            threshold <= 0;
            clear_status_r <= 0;
            multiple_triggers <= 0;
            always_armed <= 0;
            emode <= 1'b0;
            interval_threshold <= 1;
        end 
        else begin
            clear_status_r <= clear_status;
            if (reg_write) begin
                case (reg_address)
                    `SAD_TRIGGER_TIME: triggerer_init[reg_bytecnt*8 +: 8] <= reg_datai;
                    `SAD_THRESHOLD: threshold[reg_bytecnt*8 +: 8] <= reg_datai;
                    `SAD_INTERVAL_THRESHOLD: interval_threshold <= reg_datai;
                    `SAD_CONTROL: begin
                        emode <= reg_datai[2];
                    `ifndef HIPERF
                        multiple_triggers <= reg_datai[1];
                    `endif
                        always_armed <= reg_datai[0];
                    end

                    default: ;
                endcase
                if (reg_address == `SAD_STATUS)
                    clear_status <= 1'b1;
                else
                    clear_status <= 1'b0;
            end

            if (reg_write && (reg_address == `SAD_REFERENCE) && ~refsamples_wr)
                refsamples_wr <= 1'b1;
            else
                refsamples_wr <= 1'b0;

            if (reg_write && (reg_address == `SAD_REFEN) && ~refen_wr)
                refen_wr <= 1'b1;
            else
                refen_wr <= 1'b0;

            if (reg_write && (reg_address == `SAD_CONTROL) && ~sad_control_write)
                sad_control_write <= 1'b1;
            else
                sad_control_write <= 1'b0;

        end
    end

   cdc_pulse U_clear_status_cdc (
      .reset_i       (reset),
      .src_clk       (clk_usb),
      .src_pulse     (clear_status && ~clear_status_r),
      .dst_clk       (adc_sampleclk),
      .dst_pulse     (clear_status_adc)
   );

   cdc_pulse U_sad_control_cdc (
      .reset_i       (reset),
      .src_clk       (clk_usb),
      .src_pulse     (sad_control_write),
      .dst_clk       (adc_sampleclk),
      .dst_pulse     (sad_control_write_adc)
   );

    // armed_and_ready needs to be handled with care because it stays high if
    // a capture fails (i.e. even after it times out). In the capture logic
    // this is fine because it will get cleared when the next capture is
    // initiated. With this SAD implementation, that's a problem because we
    // can't write SAD_REFERENCE or SAD_REFEN when armed_and_ready is high. So
    // we use an explicit write to SAD_CONTROL to clear it.
    always @(posedge adc_sampleclk) begin
        armed_and_ready_r <= armed_and_ready;
        if (~armed_and_ready || sad_control_write_adc)
            armed_and_ready_sad <= 1'b0;
        else if (armed_and_ready && ~armed_and_ready_r)
            armed_and_ready_sad <= 1'b1;
    end


    always @(posedge adc_sampleclk) begin
        if (clear_status_adc || (armed_and_ready && ~armed_and_ready_r)) begin
            triggered <= 1'b0;
            num_triggers <= 0;
        end
        else if (trigger) begin
            triggered <= 1'b1;
            num_triggers <= num_triggers + 1;
        end
    end

    wire [pMASTER_COUNTER_WIDTH-1:0] master_counter_top = pREF_SAMPLES-1;
    wire [pMASTER_COUNTER_WIDTH-1:0] master_counter_half = pREF_SAMPLES/2-1;

    always @(posedge adc_sampleclk) begin
        if ((armed_and_ready_sad || always_armed) && active && ~xadc_error) begin
            ready2trigger_1andup <= {ready2trigger_1andup[pNUM_COUNTERS-2:1], ready2trigger0};
            resetter <= {resetter[pNUM_COUNTERS-2:0], resetter[pNUM_COUNTERS-1]};
            triggerer <= {triggerer[pNUM_COUNTERS-2:0], triggerer[pNUM_COUNTERS-1]};
            halfpoint <= {halfpoint[pNUM_COUNTERS-2:0], halfpoint[pNUM_COUNTERS-1]};
            if (master_counter == (emode ? master_counter_top : master_counter_half)) begin
                ready2trigger0 <= 1;
                master_counter <= 0;
            end
            else
                master_counter <= master_counter + 1;
        end
        else begin
            master_counter <= 0;
            ready2trigger0 <= 0;
            ready2trigger_1andup <= 0;
            resetter <= {2'b0, 1'b1, {(pNUM_COUNTERS-3){1'b0}}};
            triggerer <= 1<<triggerer_init;
            halfpoint <= {{(pNUM_COUNTERS-2){1'b0}}, 1'b1, 1'b0};
        end
    end

    // NOTE: this is where we combine each counter's trigger into the single
    // actual trigger. This used to be a single, simple block of logic with
    // a generate statement; however for large pNUM_COUNTERS, timing could be
    // difficult. We get better implementation results by processing subgroups
    // of individual_triggers together, instead of all at once. Unfortunately
    // Verilog makes this very hard to write! You would need nested generated
    // loops (which isn't allowed). This is best solution I could find.  
    //
    // Another advantage of doing this is that pNUM_GROUPS is a parameter that
    // we can adjust, without any changes in functionality, until we get an
    // implementation that meets timing.

    wire [pNUM_COUNTERS-1:0] it;
    genvar k;
    generate
        for (k = 0; k < pNUM_COUNTERS; k = k + 1)
            assign it[k] = individual_trigger[k];
    endgenerate

    localparam pGROUP_SIZE = pNUM_COUNTERS/pNUM_GROUPS; // NOTE: result must be an integer!

    wire [pNUM_GROUPS-1:0] group_trigger;
    genvar group;
    generate
        for (group = 0; group < pNUM_COUNTERS; group = group + pGROUP_SIZE) begin
            sad_group_trigger #(
                .pGROUP_SIZE    (pGROUP_SIZE)
            ) U_group_trigger (
                .clock          (adc_sampleclk),
                .trigger_inputs (it[group+pGROUP_SIZE-1:group]),
                .trigger_output (group_trigger[group/pGROUP_SIZE])
            );
        end
    endgenerate

    always @(posedge adc_sampleclk) begin
        if (~active || (~armed_and_ready_sad && ~always_armed) || ~trigger_allowed)
            trigger <= 1'b0;
        else begin
            if (~(triggered && ~multiple_triggers)) 
                trigger <= |group_trigger;
            else
                trigger <= 1'b0;
        end
    end



    always @(posedge adc_sampleclk) begin
        adc_datain_r <= adc_datain;
        adc_datain_rpr <= adc_datain_r;
        adc_datain_rmr <= -adc_datain_r;
    end

    genvar j;
    generate 
        for (j = 0; j < pREF_SAMPLES; j = j + 1) begin: gen_refsamples
            assign refsample[j] =  refsamples[j*pBITS_PER_SAMPLE +: pBITS_PER_SAMPLE];
        end
    endgenerate 


    fifo_async #(
        .pDATA_WIDTH    (pBITS_PER_SAMPLE),
        .pDEPTH         (8),
        .pFALLTHROUGH   (1),
        .pFLOPS         (1),
        .pDISTRIBUTED   (0),
        .pBRAM          (0)
    ) U_refsamples_cdc_fifo (
        .wclk                   (clk_usb),
        .rclk                   (adc_sampleclk),
        .wrst_n                 (~reset),
        .rrst_n                 (~reset),
        .wfull_threshold_value  (0),
        .rempty_threshold_value (0),
        .wen                    (refsamples_wr),
        .wdata                  (reg_datai),
        .wfull                  (),
        .walmost_full           (),
        .woverflow              (refsamples_overflow_error),
        .wfull_threshold        (),
        .ren                    (refsamples_rd),
        .rdata                  (refsamples_dout),
        .rempty                 (refsamples_empty),
        .ralmost_empty          (),
        .rempty_threshold       (),
        .runderflow             (refsamples_underflow_error)
    );

    fifo_async #(
        .pDATA_WIDTH    (8),
        .pDEPTH         (8),
        .pFALLTHROUGH   (1),
        .pFLOPS         (1),
        .pDISTRIBUTED   (0),
        .pBRAM          (0)
    ) U_refen_cdc_fifo (
        .wclk                   (clk_usb),
        .rclk                   (adc_sampleclk),
        .wrst_n                 (~reset),
        .rrst_n                 (~reset),
        .wfull_threshold_value  (0),
        .rempty_threshold_value (0),
        .wen                    (refen_wr),
        .wdata                  (reg_datai),
        .wfull                  (),
        .walmost_full           (),
        .woverflow              (refen_overflow_error),
        .wfull_threshold        (),
        .ren                    (refen_rd),
        .rdata                  (refen_dout),
        .rempty                 (refen_empty),
        .ralmost_empty          (),
        .rempty_threshold       (),
        .runderflow             (refen_underflow_error)
    );


    assign refsamples_rd = ~refsamples_empty;
    assign refen_rd = ~refen_empty;

    wire shifter_active = (((armed_and_ready_sad || always_armed) && active) || (refsample_shift_count != 0));

    //assign sad_debug = {trigger, armed_and_ready_sad, always_armed, (refsample_shift_count == 0), armed_and_ready, armed_and_ready_r, sad_control_write_adc, shifter_active};
    //assign sad_debug = {refen_empty, shifter_active, refen_wr, &refen, refen[pREF_SAMPLES-1:pREF_SAMPLES-2], refen_dout[7:6]};
    assign sad_debug = {trigger, armed_and_ready, armed_and_ready_sad, active, shifter_active, always_armed, (refsample_shift_count == 0), &ready2trigger_all};


    integer d;
    always @(posedge adc_sampleclk) begin
        if (shifter_active || ~refsamples_empty || ~refen_empty) begin
            if (shifter_active)
                if (refsample_shift_count < pNUM_COUNTERS-1)
                    refsample_shift_count <= refsample_shift_count + 1;
                else
                    refsample_shift_count <= 0;
            if (shifter_active || ~refsamples_empty) begin
                for (d = 0; d < pREF_SAMPLES; d = d + 1) begin
                    if (refsamples_empty) begin
                        if (d == pREF_SAMPLES-1)
                            refsamples[d*pBITS_PER_SAMPLE +: pBITS_PER_SAMPLE] <= refsamples[pREF_SAMPLES/2*pBITS_PER_SAMPLE +: pBITS_PER_SAMPLE];
                        else if (d == pREF_SAMPLES/2-1)
                            refsamples[d*pBITS_PER_SAMPLE +: pBITS_PER_SAMPLE] <= refsamples[0 +: pBITS_PER_SAMPLE];
                        else
                            refsamples[d*pBITS_PER_SAMPLE +: pBITS_PER_SAMPLE] <= refsamples[(d+1)*pBITS_PER_SAMPLE +: pBITS_PER_SAMPLE];
                    end
                    else begin
                        if (d == pREF_SAMPLES-1)
                            refsamples[d*pBITS_PER_SAMPLE +: pBITS_PER_SAMPLE] <= refsamples_dout;
                        else
                            refsamples[d*pBITS_PER_SAMPLE +: pBITS_PER_SAMPLE] <= refsamples[(d+1)*pBITS_PER_SAMPLE +: pBITS_PER_SAMPLE];
                    end
                end
            end

            if (shifter_active)
                refen <= {refen[pREF_SAMPLES/2], refen[pREF_SAMPLES-1:pREF_SAMPLES/2+1],
                          refen[0],              refen[pREF_SAMPLES/2-1:1]};
            else if (~refen_empty)
                refen <= {refen_dout, refen[pREF_SAMPLES-1:8]};
        end
    end

    wire [pBITS_PER_SAMPLE-1:0] ref_sample0_short = refsamples[0 +: pBITS_PER_SAMPLE];
    wire [pBITS_PER_SAMPLE-1:0] ref_sample0_extended = refsamples[pREF_SAMPLES/2*pBITS_PER_SAMPLE +: pBITS_PER_SAMPLE];
    wire refen_sample0_short = refen[0];
    wire refen_sample0_extended = refen[pREF_SAMPLES/2];

    // instantiate counters and do most of the heavy lifting:
    genvar i;
    generate 
        for (i = 0; i < pNUM_COUNTERS; i = i + 1) begin: gen_sad_counters

            always @(posedge adc_sampleclk) begin
                if (i == 0) begin
                    nextrefsample_short[0]    <= ref_sample0_short;
                    nextrefsample_extended[0] <= ref_sample0_extended;
                    compare_en_short[0]       <= refen_sample0_short;
                    compare_en_extended[0]    <= refen_sample0_extended;

                    if (extended_mode[0]) begin
                        nextrefsample[0] <= ref_sample0_extended;
                        compare_en[0] <= refen_sample0_extended;
                    end
                    else begin
                        nextrefsample[0] <= ref_sample0_short;
                        compare_en[0] <= refen_sample0_short;
                    end
                end

                else begin
                    nextrefsample_short[i] <= nextrefsample_short[i-1];
                    nextrefsample_extended[i] <= nextrefsample_extended[i-1];
                    compare_en_short[i] <= compare_en_short[i-1];
                    compare_en_extended[i] <= compare_en_extended[i-1];
                    if (extended_mode[i]) begin
                        nextrefsample[i] <= nextrefsample_extended[i-1];
                        compare_en[i] <= compare_en_extended[i-1];
                    end
                    else begin
                        nextrefsample[i] <= nextrefsample_short[i-1];
                        compare_en[i] <= compare_en_short[i-1];
                    end
                end

                nextrefsample_r[i] <= nextrefsample[i];
                compare_en_r[i] <= compare_en[i];

                if (adc_datain_r > nextrefsample[i])
                    decision[i] <= 1'b1;
                else
                    decision[i] <= 1'b0;

                if (compare_en_r[i] == 0)
                    counter_incr[i] <= 0;
                else if (decision[i])
                    counter_incr[i] <= adc_datain_rpr - nextrefsample_r[i];
                else
                    counter_incr[i] <= adc_datain_rmr + nextrefsample_r[i];


                if (~((armed_and_ready_sad || always_armed) && active && ~xadc_error)) begin
                    // important to reset this! However, it's not necessary to reset sad_counter - they will take care of themselves
                    if (emode) begin
                        extended_mode[i] <= {pNUM_COUNTERS{1'b0}}; 
                        trigger_possible[i] <= {pNUM_COUNTERS{1'b0}}; // this is the culprit which somehow makes Vivado eliminate adc_sampleclk!
                    end
                    else begin
                        extended_mode[i] <= {pNUM_COUNTERS{1'b0}}; 
                        trigger_possible[i] <= {pNUM_COUNTERS{1'b1}}; // this is the culprit which somehow makes Vivado eliminate adc_sampleclk!
                    end
                end
                else if (halfpoint[i] && emode) begin
                    if (extended_mode[i]) begin
                        extended_mode[i] <= 1'b0;
                        trigger_possible[i] <= 1'b1;
                    end
                    else if (sad_counter[i] < half_threshold) begin
                        extended_mode[i] <= 1'b1;
                        trigger_possible[i] <= 1'b0;
                    end
                    else begin
                        extended_mode[i] <= 1'b0;
                        trigger_possible[i] <= 1'b0;
                    end
                end

                if (`INTERVAL_MATCHING == 1) begin
                    if (resetter[i] && ~extended_mode[i])
                        sad_counter[i] <= ((counter_incr[i] <= interval_threshold)? 0 : 1);
                    else if (~(&(sad_counter[i]))) // don't overflow
                        sad_counter[i] <= sad_counter[i] + ((counter_incr[i] <= interval_threshold)? 0 : 1);
                end
                else begin
                    if (resetter[i] && ~extended_mode[i])
                        sad_counter[i] <= counter_incr[i];
                    else if (~sad_counter[i][pACTUAL_SAD_COUNTER_WIDTH-1]) // MSB of counter is used to indicate saturation
                        sad_counter[i] <= sad_counter[i] + counter_incr[i];
                end

            end

            always @ (posedge adc_sampleclk) begin
                //if ((sad_counter[i] <= threshold) && resetter[i] && trigger_possible[i] && ready2trigger_all[i])
                if ((sad_counter[i] <= threshold) && triggerer[i] && trigger_possible[i] && ready2trigger_all[i])
                    individual_trigger[i] <= 1'b1;
                else
                    individual_trigger[i] <= 1'b0;
            end

        end
    endgenerate

    // for debug only:
    // verilator lint_off UNUSED
    // verilator lint_off WIDTH
    wire [pBITS_PER_SAMPLE-1:0] refsample0 = refsample[0];
    wire [pBITS_PER_SAMPLE-1:0] refsample1 = refsample[1];
    wire [pBITS_PER_SAMPLE-1:0] refsample2 = refsample[2];
    wire [pBITS_PER_SAMPLE-1:0] refsample3 = refsample[3];

    wire [pBITS_PER_SAMPLE-1:0] nextrefsample0 = nextrefsample[0];
    wire [pBITS_PER_SAMPLE-1:0] nextrefsample1 = nextrefsample[1];
    wire [pBITS_PER_SAMPLE-1:0] nextrefsample2 = nextrefsample[2];
    wire [pBITS_PER_SAMPLE-1:0] nextrefsample3 = nextrefsample[3];
    wire [pBITS_PER_SAMPLE-1:0] nextrefsample4 = nextrefsample[4];
    wire [pBITS_PER_SAMPLE-1:0] nextrefsample5 = nextrefsample[5];
    wire [pBITS_PER_SAMPLE-1:0] nextrefsample6 = nextrefsample[6];
    wire [pBITS_PER_SAMPLE-1:0] nextrefsample7 = nextrefsample[7];
    wire [pBITS_PER_SAMPLE-1:0] nextrefsample8 = nextrefsample[8];
    wire [pBITS_PER_SAMPLE-1:0] nextrefsample9 = nextrefsample[9];
    wire [pBITS_PER_SAMPLE-1:0] nextrefsample10 = nextrefsample[10];
    wire [pBITS_PER_SAMPLE-1:0] nextrefsample18 = nextrefsample[18];
    wire [pBITS_PER_SAMPLE-1:0] nextrefsample12 = nextrefsample[12];
    wire [pBITS_PER_SAMPLE-1:0] nextrefsample12r = nextrefsample_r[12];
    wire [pBITS_PER_SAMPLE-1:0] nextrefsample24 = nextrefsample[24];
    wire [pBITS_PER_SAMPLE-1:0] nextrefsample24r = nextrefsample_r[24];
    wire [pBITS_PER_SAMPLE-1:0] nextrefsample28 = nextrefsample[28];
    wire [pBITS_PER_SAMPLE-1:0] nextrefsample28r = nextrefsample_r[28];

    wire [pBITS_PER_SAMPLE-1:0] nextrefsample_short0 = nextrefsample_short[0];
    wire [pBITS_PER_SAMPLE-1:0] nextrefsample_short1 = nextrefsample_short[1];
    wire [pBITS_PER_SAMPLE-1:0] nextrefsample_short14 = nextrefsample_short[14];
    wire [pBITS_PER_SAMPLE-1:0] nextrefsample_short27 = nextrefsample_short[27];
    wire [pBITS_PER_SAMPLE-1:0] nextrefsample_short28 = nextrefsample_short[28];

    wire [pBITS_PER_SAMPLE-1:0] nextrefsample_extended0  = nextrefsample_extended[0];
    wire [pBITS_PER_SAMPLE-1:0] nextrefsample_extended1  = nextrefsample_extended[1];
    wire [pBITS_PER_SAMPLE-1:0] nextrefsample_extended14 = nextrefsample_extended[14];
    wire [pBITS_PER_SAMPLE-1:0] nextrefsample_extended27 = nextrefsample_extended[27];
    wire [pBITS_PER_SAMPLE-1:0] nextrefsample_extended28 = nextrefsample_extended[28];

    wire [pACTUAL_SAD_COUNTER_WIDTH-1:0] sad_counter0  = sad_counter[0 ];
    wire [pACTUAL_SAD_COUNTER_WIDTH-1:0] sad_counter1  = sad_counter[1 ];
    wire [pACTUAL_SAD_COUNTER_WIDTH-1:0] sad_counter2  = sad_counter[2 ];
    wire [pACTUAL_SAD_COUNTER_WIDTH-1:0] sad_counter3  = sad_counter[3 ];
    wire [pACTUAL_SAD_COUNTER_WIDTH-1:0] sad_counter4  = sad_counter[4 ];
    wire [pACTUAL_SAD_COUNTER_WIDTH-1:0] sad_counter5  = sad_counter[5 ];
    wire [pACTUAL_SAD_COUNTER_WIDTH-1:0] sad_counter6  = sad_counter[6 ];
    wire [pACTUAL_SAD_COUNTER_WIDTH-1:0] sad_counter7  = sad_counter[7 ];
    wire [pACTUAL_SAD_COUNTER_WIDTH-1:0] sad_counter8  = sad_counter[8 ];
    wire [pACTUAL_SAD_COUNTER_WIDTH-1:0] sad_counter9  = sad_counter[9 ];
    wire [pACTUAL_SAD_COUNTER_WIDTH-1:0] sad_counter10 = sad_counter[10];
    wire [pACTUAL_SAD_COUNTER_WIDTH-1:0] sad_counter11 = sad_counter[11];
    wire [pACTUAL_SAD_COUNTER_WIDTH-1:0] sad_counter12 = sad_counter[12];
    wire [pACTUAL_SAD_COUNTER_WIDTH-1:0] sad_counter13 = sad_counter[13];
    wire [pACTUAL_SAD_COUNTER_WIDTH-1:0] sad_counter14 = sad_counter[14];
    wire [pACTUAL_SAD_COUNTER_WIDTH-1:0] sad_counter15 = sad_counter[15];
    wire [pACTUAL_SAD_COUNTER_WIDTH-1:0] sad_counter16 = sad_counter[16];
    wire [pACTUAL_SAD_COUNTER_WIDTH-1:0] sad_counter17 = sad_counter[17];
    wire [pACTUAL_SAD_COUNTER_WIDTH-1:0] sad_counter18 = sad_counter[18];
    wire [pACTUAL_SAD_COUNTER_WIDTH-1:0] sad_counter19 = sad_counter[19];
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
                                             individual_trigger[2],
                                             individual_trigger[1],
                                             individual_trigger[0]};

    // verilator lint_on UNUSED
    // verilator lint_on WIDTH

   `ifdef ILA_SAD
       ila_sad U_ila_sad (
          .clk            (clk_usb),              // input wire clk
          .probe0         (adc_datain),           // input wire [7:0]  probe0 
          .probe1         (state),                // input wire [1:0]  probe1 
          .probe2         (individual_trigger_debug),// input wire [31:0]  probe2 
          .probe3         (trigger),              // input wire [0:0]  probe3 
          .probe4         (sad_counter0),         // input wire [15:0]  probe4 
          .probe5         (sad_counter1),         // input wire [15:0]  probe5 
          .probe6         (refsamples[31:0]),     // input wire [31:0]  probe6 
          .probe7         (counter_counter0),     // input wire [6:0]  probe7 
          .probe8         (arm_i),                // input wire [0:0]  probe8 
          .probe9         (ext_trigger)           // input wire [0:0]  probe9
       );
   `endif
   //


endmodule
`default_nettype wire
