newaetech/chipwhisperer-husky-fpga/fpga/hdl/sad_x2.v

`include "includes.v"
`timescale 1 ns / 1 ps
`default_nettype none

/***********************************************************************
This file is part of the ChipWhisperer Project. See www.newae.com for more
details, or the codebase at http://www.chipwhisperer.com

Copyright (c) 2024, NewAE Technology Inc. All rights reserved.
Author: Jean-Pierre Thibault <jpthibault@newae.com>

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

Notes on instantiation parameters:
==================================
pREF_SAMPLES is the length of the SAD pattern; it can be adjusted to control
the size of the implementation. It must be a multiple of 2.

pSAD_COUNTER_WIDTH controls the width of the SAD counters, and therefore
limits the maximum SAD that can be computed; it has a significant effect on
size.

pBITS_PER_SAMPLE is the ADC sample size that is used for the SAD computation.
In theory this could be anything; in practice values != 8 have not been tested.

Other paramaters should not be touched.

*************************************************************************/

module sad_x2 #(
    parameter pBYTECNT_SIZE = 7,
    parameter pREF_SAMPLES = 32, 
    parameter pBITS_PER_SAMPLE = 8,
    parameter pSAD_COUNTER_WIDTH = 16
)(
    input wire          reset,
    input wire          xadc_error,

    //ADC Sample Input
    input wire [pBITS_PER_SAMPLE-1:0] adc_datain,
    input wire          adc_sampleclk,
    input wire          armed_and_ready,
    input wire          active,
    input wire          trigger_allowed,

    //USB register interface
    input wire          clk_usb,
    input  wire [7:0]   reg_address,  // Address of register
    input  wire [pBYTECNT_SIZE-1:0]  reg_bytecnt,  // Current byte count
    input  wire [7:0]   reg_datai,    // Data to write
    output reg  [7:0]   reg_datao,    // Data to read
    input  wire         reg_read,     // Read flag
    input  wire         reg_write,    // Write flag

    // verilator lint_off UNUSED
    input  wire         ext_trigger,  // debug only
    input  wire         io4,  // debug only
    // verilator lint_on UNUSED
    output reg          trigger
);

    localparam pSADS_PER_CYCLE = 2;
    localparam pMASTER_COUNTER_WIDTH = (pREF_SAMPLES <= 32)?  5 :
                                       (pREF_SAMPLES <= 64)?  6 :
                                       (pREF_SAMPLES <= 128)? 7 :
                                       (pREF_SAMPLES <= 256)? 8 :
                                       (pREF_SAMPLES <= 512)? 9 :
                                       (pREF_SAMPLES <= 1024)? 10 : 11;

    reg  triggered = 1'b0;
    reg [15:0] num_triggers;
    reg clear_status;
    reg clear_status_r;
    wire clear_status_adc;

    reg always_armed;
    reg multiple_triggers;
    reg emode;
    reg [pREF_SAMPLES*pBITS_PER_SAMPLE-1:0] refsamples;
    reg [pREF_SAMPLES-1:0] refen = {pREF_SAMPLES{1'b1}}; // all samples enabled by default
    reg [pREF_SAMPLES-1:0] compare_en_a, compare_en_b;
    reg [pREF_SAMPLES-1:0] compare_en_ar, compare_en_br;
    reg [pSAD_COUNTER_WIDTH-1:0] threshold;
    wire [pMASTER_COUNTER_WIDTH-1:0] master_counter;
    reg [pMASTER_COUNTER_WIDTH-1:0] master_counter_full;
    reg [pMASTER_COUNTER_WIDTH-1:0] refsample_shift_count = 0;
    wire tick_tock;
    reg resetter [0:pREF_SAMPLES-1];

    reg individual_trigger [0:pREF_SAMPLES-1];
    reg [pSAD_COUNTER_WIDTH-1:0] sad_counter [0:pREF_SAMPLES-1];
    reg [pBITS_PER_SAMPLE-1:0] counter_incr [0:pREF_SAMPLES-1];

    wire armed_and_ready_adc;
    wire armed_and_ready_adc_r;
    wire active_adc;

    reg ready2trigger [0:pREF_SAMPLES-1];

    reg decision_a [0:pREF_SAMPLES-1];
    reg decision_b [0:pREF_SAMPLES-1];
    reg [pBITS_PER_SAMPLE-1:0]  nextrefsample_a [0:pREF_SAMPLES-1];
    reg [pBITS_PER_SAMPLE-1:0]  nextrefsample_b [0:pREF_SAMPLES-1];
    reg [pBITS_PER_SAMPLE-1:0]  nextrefsample_ar [0:pREF_SAMPLES-1];
    reg [pBITS_PER_SAMPLE-1:0]  nextrefsample_br [0:pREF_SAMPLES-1];
    wire [pBITS_PER_SAMPLE-1:0]  refsample [0:pREF_SAMPLES-1];
    reg [pBITS_PER_SAMPLE-1:0] adc_datain_r;
    reg [pBITS_PER_SAMPLE-1:0] datain_a;
    reg [pBITS_PER_SAMPLE-1:0] datain_b;

    // sign extension:
    reg [pBITS_PER_SAMPLE-1:0] datain_a_rpr;
    reg [pBITS_PER_SAMPLE-1:0] datain_a_rmr;
    reg [pBITS_PER_SAMPLE-1:0] datain_b_rpr;
    reg [pBITS_PER_SAMPLE-1:0] datain_b_rmr;


`ifdef HIPERF
    wire [23:0] status_reg = 24'b0;
`else
    wire [23:0] status_reg = {num_triggers, 7'b0, triggered};
`endif

    wire [31:0] wide_threshold_reg = {{(32-pSAD_COUNTER_WIDTH){1'b0}}, threshold}; // having a variable-width register isn't very convenient for Python
    reg [7:0] refbase;

    // See sad.v for definitions:
    wire max_threshold = 1'b0;
    wire esad_support = 1'b0;
    wire im_support = 1'b0;
    wire [2:0] version = 3'b101;
    wire [4:0] latency = 5'd10;
    wire [10:0] version_bits = {max_threshold, esad_support, im_support, version, latency};

    wire [15:0] ref_samples = pREF_SAMPLES;

    reg [7:0] sad_reference_data;
    reg [pBYTECNT_SIZE+7:0] sad_reference_index;
    reg sad_reference_usb;
    reg [7:0] sad_refen_data;
    reg [pBYTECNT_SIZE-1:0] sad_refen_index;
    reg sad_refen_usb;

    // register reads:
    always @(*) begin
        if (reg_read) begin
            case (reg_address)
                `SAD_REFERENCE: reg_datao = refsamples[{refbase, reg_bytecnt}*8 +: 8];
                `SAD_REFEN: reg_datao = refen[reg_bytecnt*8 +: 8];
                `SAD_THRESHOLD: reg_datao = wide_threshold_reg[reg_bytecnt*8 +: 8];
                `SAD_STATUS: reg_datao = status_reg[reg_bytecnt*8 +: 8];
                `SAD_BITS_PER_SAMPLE: reg_datao = pBITS_PER_SAMPLE;
                `SAD_REF_SAMPLES: reg_datao = ref_samples[reg_bytecnt*8 +: 8];
                `SAD_COUNTER_WIDTH: reg_datao = pSAD_COUNTER_WIDTH;
                `SAD_VERSION: reg_datao = version_bits[reg_bytecnt*8 +: 8];
                `SAD_CONTROL: reg_datao = {5'b0, emode, multiple_triggers, always_armed};
                default: reg_datao = 0;
            endcase
        end
        else
            reg_datao = 0;
    end

    // register writes:
    always @(posedge clk_usb) begin
        if (reset) begin
            refsamples <= 0;
            threshold <= 0;
            clear_status_r <= 0;
            multiple_triggers <= 0;
            refbase <= 0;
            always_armed <= 0;
            refen <= {pREF_SAMPLES{1'b1}}; // all samples enabled by default
        end 
        else begin
            clear_status_r <= clear_status;
            sad_reference_usb <= 1'b0;
            sad_refen_usb <= 1'b0;
            if (reg_write) begin
                case (reg_address)
                    `SAD_REFERENCE: begin
                        sad_reference_data <= reg_datai;
                        sad_reference_index <= {refbase, reg_bytecnt};
                        sad_reference_usb <= 1'b1;
                    end

                    `SAD_REFEN: begin
                        sad_refen_data <= reg_datai;
                        sad_refen_index <= reg_bytecnt;
                        sad_refen_usb <= 1'b1;
                    end

                    `SAD_THRESHOLD: threshold[reg_bytecnt*8 +: 8] <= reg_datai;
                    `SAD_REFERENCE_BASE: refbase <= reg_datai;
                    `SAD_CONTROL: begin
                        emode <= reg_datai[2];
                    `ifndef HIPERF
                        multiple_triggers <= reg_datai[1];
                    `endif
                        always_armed <= reg_datai[0];
                    end

                    default: ;
                endcase
                if (reg_address == `SAD_STATUS)
                    clear_status <= 1'b1;
                else
                    clear_status <= 1'b0;
            end
        end
    end

   cdc_pulse U_clear_status_cdc (
      .reset_i       (reset),
      .src_clk       (clk_usb),
      .src_pulse     (clear_status && ~clear_status_r),
      .dst_clk       (adc_sampleclk),
      .dst_pulse     (clear_status_adc)
   );


    integer c;
    reg trigger_r;
    always @(posedge adc_sampleclk) begin
        if (clear_status_adc || (armed_and_ready_adc && ~armed_and_ready_adc_r)) begin
            triggered <= 1'b0;
            num_triggers <= 0;
        end
        else if (trigger && ~trigger_r) begin
            triggered <= 1'b1;
            num_triggers <= num_triggers + 1;
        end

        // TODO: active check? would it be redundant?
        trigger <= 1'b0;
        trigger_r <= trigger;
        for (c = 0; c < pREF_SAMPLES; c = c + 1) begin
            if (individual_trigger[c] && ~(triggered && ~multiple_triggers) && trigger_allowed) 
                trigger <= 1'b1;
        end
    end


    cdc_simple U_armed_and_ready_cdc (
        .reset          (reset),
        .clk            (adc_sampleclk),
        .data_in        (armed_and_ready),
        .data_out       (armed_and_ready_adc),
        .data_out_r     (armed_and_ready_adc_r)
    );

    cdc_simple U_active_cdc (
        .reset          (reset),
        .clk            (adc_sampleclk),
        .data_in        (active),
        .data_out       (active_adc),
        .data_out_r     ()
    );


    wire [pMASTER_COUNTER_WIDTH-1:0] master_counter_top = pREF_SAMPLES-pSADS_PER_CYCLE;


    always @(posedge adc_sampleclk) begin
        adc_datain_r  <= adc_datain;
        datain_b      <= adc_datain;
        datain_a      <= adc_datain_r;
        datain_b_rpr  <=  datain_b;
        datain_b_rmr  <= -datain_b;
        datain_a_rpr  <=  datain_a;
        datain_a_rmr  <= -datain_a;
    end

    always @(posedge adc_sampleclk) begin
        // TODO: this condition is being used in several places, should declare a meaningful wire instead
        if ((armed_and_ready_adc || always_armed) && active_adc && ~xadc_error)
            if (master_counter_full == pREF_SAMPLES-1)
                master_counter_full <= 0;
            else
                master_counter_full <= master_counter_full + 1;
        else
            master_counter_full <= 0;
    end

    assign master_counter = {master_counter_full[pMASTER_COUNTER_WIDTH-1:1], 1'b0};
    assign tick_tock = master_counter_full[0];


    // heavy lifting part 1: per-**reference-sample** generated logic:
    genvar j;
    generate
        for (j = 0; j < pREF_SAMPLES; j = j + 1) begin: gen_per_refsample
            assign refsample[j] = refsamples[j*pBITS_PER_SAMPLE +: pBITS_PER_SAMPLE];

            always @(posedge adc_sampleclk) begin
                if ((armed_and_ready_adc || always_armed) && active_adc && ~xadc_error) begin
                    if (j > 0) ready2trigger[j] <= ready2trigger[j-1];
                    else if (master_counter == master_counter_top) ready2trigger[0] <= 1;

                    if (j == 0) resetter[j] <= resetter[pREF_SAMPLES-1];
                    else resetter[j] <= resetter[j-1];

                end

                else begin
                    ready2trigger[j] <= 0;
                    if (j == pREF_SAMPLES - pSADS_PER_CYCLE - 1) resetter[j] <= 1'b1;
                    else resetter[j] <= 1'b0;
                end

                if (j%2) begin
                    if (resetter[j])
                        sad_counter[j] <= counter_incr[j-1];
                    // TODO: this is not guaranteed to avoid overflow! need a better counter saturation scheme
                    else if (~tick_tock && ~sad_counter[j][pSAD_COUNTER_WIDTH-1]) // MSB of counter is used to indicate saturation
                        sad_counter[j] <= sad_counter[j] + counter_incr[j-1];
                end
                else begin
                    if (resetter[j])
                        sad_counter[j] <= counter_incr[j];
                    else if (tick_tock && ~sad_counter[j][pSAD_COUNTER_WIDTH-1]) // MSB of counter is used to indicate saturation
                        sad_counter[j] <= sad_counter[j] + counter_incr[j];
                end


                // and the triggers:
                if ((sad_counter[j] <= threshold) && resetter[j] && ready2trigger[j])
                    individual_trigger[j] <= 1'b1;
                else
                    individual_trigger[j] <= 1'b0;

            end
        end

    endgenerate


    wire sad_reference_adc;
    cdc_pulse U_refsample_cdc (
       .reset_i       (reset),
       .src_clk       (clk_usb),
       .src_pulse     (sad_reference_usb),
       .dst_clk       (adc_sampleclk),
       .dst_pulse     (sad_reference_adc)
    );

    wire sad_refen_adc;
    cdc_pulse U_refen_cdc (
       .reset_i       (reset),
       .src_clk       (clk_usb),
       .src_pulse     (sad_refen_usb),
       .dst_clk       (adc_sampleclk),
       .dst_pulse     (sad_refen_adc)
    );

    integer d;
    always @(posedge adc_sampleclk) begin
        if (((armed_and_ready_adc || always_armed) && tick_tock) || (~(armed_and_ready_adc || always_armed) && (refsample_shift_count != 0))) begin
            refsample_shift_count <= refsample_shift_count + 2;
            for (d = 0; d < pREF_SAMPLES; d = d + 2) begin
                if (d == pREF_SAMPLES-2)
                    refsamples[d*pBITS_PER_SAMPLE +: pBITS_PER_SAMPLE*2] <= refsamples[0 +: pBITS_PER_SAMPLE*2];
                else
                    refsamples[d*pBITS_PER_SAMPLE +: pBITS_PER_SAMPLE*2] <= refsamples[(d+2)*pBITS_PER_SAMPLE +: pBITS_PER_SAMPLE*2];

            end
            refen <= {refen[1:0], refen[pREF_SAMPLES-1:2]};
        end
        else begin
          if (sad_reference_adc)
              refsamples[sad_reference_index*8 +: 8] <= sad_reference_data;
          if (sad_refen_adc)
              refen[sad_refen_index*8 +: 8] <= sad_refen_data;
        end
    end

    wire [pBITS_PER_SAMPLE-1:0] ref_sample0 = refsamples[0 +: pBITS_PER_SAMPLE];
    wire [pBITS_PER_SAMPLE-1:0] ref_sample1 = refsamples[pBITS_PER_SAMPLE +: pBITS_PER_SAMPLE];
    wire refen_sample0 = refen[0];
    wire refen_sample1 = refen[1];



    // heavy lifting part 2: per-every-other-sample generated logic: (this is where we save logic c.f. sad.v)
    genvar i;
    generate 
        for (i = 0; i < pREF_SAMPLES; i = i + pSADS_PER_CYCLE) begin: gen_sad_counters
            always @(posedge adc_sampleclk) begin


                if (i == 0) begin
                    nextrefsample_a[i] <= ref_sample0;
                    nextrefsample_b[i] <= ref_sample1;
                    compare_en_a[i] <= refen_sample0;
                    compare_en_b[i] <= refen_sample1;
                end
                else begin
                    if (~tick_tock) begin
                        nextrefsample_a[i] <= nextrefsample_a[i-pSADS_PER_CYCLE];
                        nextrefsample_b[i] <= nextrefsample_b[i-pSADS_PER_CYCLE];
                        compare_en_a[i] <= compare_en_a[i-pSADS_PER_CYCLE];
                        compare_en_b[i] <= compare_en_b[i-pSADS_PER_CYCLE];
                    end
                end

                nextrefsample_ar[i] <= nextrefsample_a[i];
                nextrefsample_br[i] <= nextrefsample_b[i];
                compare_en_ar[i] <= compare_en_a[i];
                compare_en_br[i] <= compare_en_b[i];

                if (datain_b > nextrefsample_b[i])
                    decision_b[i] <= 1'b1;
                else
                    decision_b[i] <= 1'b0;

                if (datain_a > nextrefsample_a[i])
                    decision_a[i] <= 1'b1;
                else
                    decision_a[i] <= 1'b0;

                // Here is where the logic savings are (c.f. sad.v) since we have half the number of counter_incr registers:
                case ({decision_b[i], decision_a[i]})
                    2'b00: counter_incr[i] <= (compare_en_br[i]? (datain_b_rmr + nextrefsample_br[i]) : 0) + (compare_en_ar[i]? (datain_a_rmr + nextrefsample_ar[i]) : 0);
                    2'b01: counter_incr[i] <= (compare_en_br[i]? (datain_b_rmr + nextrefsample_br[i]) : 0) + (compare_en_ar[i]? (datain_a_rpr - nextrefsample_ar[i]) : 0);
                    2'b10: counter_incr[i] <= (compare_en_br[i]? (datain_b_rpr - nextrefsample_br[i]) : 0) + (compare_en_ar[i]? (datain_a_rmr + nextrefsample_ar[i]) : 0);
                    2'b11: counter_incr[i] <= (compare_en_br[i]? (datain_b_rpr - nextrefsample_br[i]) : 0) + (compare_en_ar[i]? (datain_a_rpr - nextrefsample_ar[i]) : 0);
                endcase

            end

        end
    endgenerate


    // for debug only:
    // verilator lint_off UNUSED
    // verilator lint_off WIDTH
    wire [pBITS_PER_SAMPLE-1:0] refsample0 = refsample[0];
    wire [pBITS_PER_SAMPLE-1:0] refsample1 = refsample[1];
    wire [pBITS_PER_SAMPLE-1:0] refsample2 = refsample[2];
    wire [pBITS_PER_SAMPLE-1:0] refsample3 = refsample[3];

    wire decision_a4 = decision_a[4];
    wire decision_a28 = decision_a[28];
    wire decision_b28 = decision_b[28];

    wire ready2trigger10 = ready2trigger[10];
    wire ready2trigger11 = ready2trigger[11];
    wire ready2trigger12 = ready2trigger[12];
    wire ready2trigger31 = ready2trigger[31];
    wire resetter31 = resetter[31];
    wire individual_trigger31 = individual_trigger[31];

    wire [pBITS_PER_SAMPLE-1:0] nextrefsample_a0 = nextrefsample_a[0];
    wire [pBITS_PER_SAMPLE-1:0] nextrefsample_a2 = nextrefsample_a[2];
    wire [pBITS_PER_SAMPLE-1:0] nextrefsample_a4 = nextrefsample_a[4];
    wire [pBITS_PER_SAMPLE-1:0] nextrefsample_a6 = nextrefsample_a[6];
    wire [pBITS_PER_SAMPLE-1:0] nextrefsample_a10 = nextrefsample_a[10];
    wire [pBITS_PER_SAMPLE-1:0] nextrefsample_a20 = nextrefsample_a[20];
    wire [pBITS_PER_SAMPLE-1:0] nextrefsample_a28 = nextrefsample_a[28];

    wire [pBITS_PER_SAMPLE-1:0] nextrefsample_b0 = nextrefsample_b[0];
    wire [pBITS_PER_SAMPLE-1:0] nextrefsample_b2 = nextrefsample_b[2];
    wire [pBITS_PER_SAMPLE-1:0] nextrefsample_b4 = nextrefsample_b[4];
    wire [pBITS_PER_SAMPLE-1:0] nextrefsample_b6 = nextrefsample_b[6];
    wire [pBITS_PER_SAMPLE-1:0] nextrefsample_b10 = nextrefsample_b[10];
    wire [pBITS_PER_SAMPLE-1:0] nextrefsample_b20 = nextrefsample_b[20];
    wire [pBITS_PER_SAMPLE-1:0] nextrefsample_b28 = nextrefsample_b[28];

    wire [pBITS_PER_SAMPLE-1:0] nextrefsample_ar0 = nextrefsample_ar[0];
    wire [pBITS_PER_SAMPLE-1:0] nextrefsample_ar2 = nextrefsample_ar[2];
    wire [pBITS_PER_SAMPLE-1:0] nextrefsample_ar4 = nextrefsample_ar[4];
    wire [pBITS_PER_SAMPLE-1:0] nextrefsample_ar28 = nextrefsample_ar[28];

    wire [pBITS_PER_SAMPLE-1:0] nextrefsample_br0 = nextrefsample_br[0];
    wire [pBITS_PER_SAMPLE-1:0] nextrefsample_br2 = nextrefsample_br[2];
    wire [pBITS_PER_SAMPLE-1:0] nextrefsample_br4 = nextrefsample_br[4];
    wire [pBITS_PER_SAMPLE-1:0] nextrefsample_br28 = nextrefsample_br[28];

    wire [pSAD_COUNTER_WIDTH-1:0] sad_counter0  = sad_counter[0 ];
    wire [pSAD_COUNTER_WIDTH-1:0] sad_counter1  = sad_counter[1 ];
    wire [pSAD_COUNTER_WIDTH-1:0] sad_counter2  = sad_counter[2 ];
    wire [pSAD_COUNTER_WIDTH-1:0] sad_counter3  = sad_counter[3 ];
    wire [pSAD_COUNTER_WIDTH-1:0] sad_counter4  = sad_counter[4 ];
    wire [pSAD_COUNTER_WIDTH-1:0] sad_counter5  = sad_counter[5 ];
    wire [pSAD_COUNTER_WIDTH-1:0] sad_counter6  = sad_counter[6 ];
    wire [pSAD_COUNTER_WIDTH-1:0] sad_counter7  = sad_counter[7 ];
    wire [pSAD_COUNTER_WIDTH-1:0] sad_counter8  = sad_counter[8 ];
    wire [pSAD_COUNTER_WIDTH-1:0] sad_counter9  = sad_counter[9 ];
    wire [pSAD_COUNTER_WIDTH-1:0] sad_counter10 = sad_counter[10];
    wire [pSAD_COUNTER_WIDTH-1:0] sad_counter11 = sad_counter[11];
    wire [pSAD_COUNTER_WIDTH-1:0] sad_counter12 = sad_counter[12];
    wire [pSAD_COUNTER_WIDTH-1:0] sad_counter13 = sad_counter[13];
    wire [pSAD_COUNTER_WIDTH-1:0] sad_counter14 = sad_counter[14];
    wire [pSAD_COUNTER_WIDTH-1:0] sad_counter15 = sad_counter[15];
    wire [pSAD_COUNTER_WIDTH-1:0] sad_counter16 = sad_counter[16];
    wire [pSAD_COUNTER_WIDTH-1:0] sad_counter17 = sad_counter[17];
    wire [pSAD_COUNTER_WIDTH-1:0] sad_counter18 = sad_counter[18];
    wire [pSAD_COUNTER_WIDTH-1:0] sad_counter19 = sad_counter[19];
    wire [pSAD_COUNTER_WIDTH-1:0] sad_counter20 = sad_counter[20];
    wire [pSAD_COUNTER_WIDTH-1:0] sad_counter21 = sad_counter[21];
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
                                  resetter[3],
                                  resetter[2],
                                  resetter[1],
                                  resetter[0]};



    // verilator lint_on UNUSED
    // verilator lint_on WIDTH

   `ifdef ILA_SAD_X2
       ila_sad_x2 U_ila_sad (
          .clk            (adc_sampleclk),
          .probe0         (slow_clk_even),              // 1
          .probe1         (slow_clk_odd),               // 1
          .probe2         (trigger),                    // 1
          .probe3         (triggered),                  // 1
          .probe4         (individual_trigger_debug),   // 32
          .probe5         (sad_counter0),               // 8
          .probe6         (sad_counter1),               // 8
          .probe7         (sad_counter2),               // 8
          .probe8         (sad_counter3),               // 8
          .probe9         (sad_counter4),               // 8
          .probe10        (sad_counter5),               // 8
          .probe11        (sad_counter6),               // 8
          .probe12        (sad_counter7),               // 8
          .probe13        (counter_incr_a0),            // 8
          .probe14        (counter_incr_a1),            // 8
          .probe15        (counter_incr_a2),            // 8
          .probe16        (counter_incr_a3),            // 8
          .probe17        (counter_incr_b0),            // 8
          .probe18        (counter_incr_b1),            // 8
          .probe19        (counter_incr_b2),            // 8
          .probe20        (counter_incr_b3),            // 8
          .probe21        (adc_datain),                 // 8
          .probe22        (adc_datain_r),               // 8
          .probe23        (adc_datain_r2),              // 8
          .probe24        (adc_datain_even_r),          // 8
          .probe25        (adc_datain_even_r2),         // 8
          .probe26        (adc_datain_odd_r),           // 8
          .probe27        (adc_datain_odd_r2)           // 8
      );

       ila_sad_x2_slowclk U_ila_sad_even (
          .clk            (slow_clk_even),              // 1
          .probe0         (trigger),                    // 1
          .probe1         (triggered),                  // 1
          .probe2         (individual_trigger_debug),   // 32
          .probe3         (sad_counter0),               // 8
          .probe4         (sad_counter2),               // 8
          .probe5         (sad_counter4),               // 8
          .probe6         (sad_counter6),               // 8
          .probe7         (counter_incr_a0),            // 8
          .probe8         (counter_incr_a2),            // 8
          .probe9         (counter_incr_b0),            // 8
          .probe10        (counter_incr_b2),            // 8
          .probe11        (adc_datain_even_r),          // 8
          .probe12        (adc_datain_even_r2)          // 8
      );

       ila_sad_x2_slowclk U_ila_sad_odd (
          .clk            (slow_clk_odd),               // 1
          .probe0         (trigger),                    // 1
          .probe1         (triggered),                  // 1
          .probe2         (individual_trigger_debug),   // 32
          .probe3         (sad_counter0),               // 8
          .probe4         (sad_counter2),               // 8
          .probe5         (sad_counter4),               // 8
          .probe6         (sad_counter6),               // 8
          .probe7         (counter_incr_a0),            // 8
          .probe8         (counter_incr_a2),            // 8
          .probe9         (counter_incr_b0),            // 8
          .probe10        (counter_incr_b2),            // 8
          .probe11        (adc_datain_odd_r),           // 8
          .probe12        (adc_datain_odd_r2)           // 8
      );


   `endif

endmodule
`default_nettype wire
