newaetech/chipwhisperer-husky-fpga/fpga/hdl/userio.v

`default_nettype none
`timescale 1ns / 1ps

/***********************************************************************
This file is part of the ChipWhisperer Project. See www.newae.com for more details,
or the codebase at https://github.com/newaetech/chipwhisperer .

Copyright (c) 2021-2025, Colin O'Flynn <coflynn@newae.com>. All rights reserved.
Author: Jean-Pierre Thibault <jpthibault@newae.com>
This project (and file) is released under the 2-Clause BSD License:

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
THIS SOFTWARE IS PROVIDED BY THE COPYRIGHT HOLDERS AND CONTRIBUTORS "AS IS"
AND ANY EXPRESS OR IMPLIED WARRANTIES, INCLUDING, BUT NOT LIMITED TO, THE
IMPLIED WARRANTIES OF MERCHANTABILITY AND FITNESS FOR A PARTICULAR PURPOSE
ARE DISCLAIMED. IN NO EVENT SHALL THE COPYRIGHT HOLDER OR CONTRIBUTORS BE
LIABLE FOR ANY DIRECT, INDIRECT, INCIDENTAL, SPECIAL, EXEMPLARY, OR
CONSEQUENTIAL DAMAGES (INCLUDING, BUT NOT LIMITED TO, PROCUREMENT OF
SUBSTITUTE GOODS OR SERVICES; LOSS OF USE, DATA, OR PROFITS; OR BUSINESS
INTERRUPTION) HOWEVER CAUSED AND ON ANY THEORY OF LIABILITY, WHETHER IN
CONTRACT, STRICT LIABILITY, OR TORT (INCLUDING NEGLIGENCE OR OTHERWISE)
ARISING IN ANY WAY OUT OF THE USE OF THIS SOFTWARE, EVEN IF ADVISED OF THE
POSSIBILITY OF SUCH DAMAGE.
*************************************************************************/

module userio #(
    parameter pWIDTH = 8,
    parameter pBYTECNT_SIZE = 7,
    parameter pPLL_CLOCKS = 6
)(
    input  wire                         reset,
    input  wire                         usb_clk,
    input  wire                         target_clk,
    input  wire                         pll_shutdown,

    input  wire [7:0]                   reg_address,
    input  wire [pBYTECNT_SIZE-1:0]     reg_bytecnt,
    input  wire [7:0]                   reg_datai,
    output wire [7:0]                   reg_datao,
    input  wire                         reg_read,
    input  wire                         reg_write,

    input  wire                         trace_en,
    input  wire [7:0]                   trace_userio_dir,
    input  wire                         target_MOSI,
    input  wire                         target_PDID,
    input  wire                         target_SCK,
    input  wire                         FPGA_BONUS1,

    output reg [4:0]                    userio_fpga_debug_select,
    output reg                          userio_target_debug,
    output reg                          userio_target_debug_swd,

    input  wire [7:0]                   bb_trig_select,
    input  wire                         bb_data_out,
    input  wire                         bb_data_drive,
    input  wire                         bb_clock_out,

    inout  wire [pWIDTH-1:0]            userio_d,
    input  wire [pWIDTH-1:0]            I_userio_debug_data,
    inout  wire                         userio_clk
);

    wire [5:0] pll_out;
    wire locked;

    // most of these are pWIDTH+1 because of the CK pin
    wire [pWIDTH:0] userio_cwdriven;
    reg  [pWIDTH:0] reg_userio_cwdriven;
    reg  [pWIDTH:0] userio_clockout;
    wire [pWIDTH:0] userio_clockgen = {{(9-pPLL_CLOCKS){1'b0}}, pll_out[pPLL_CLOCKS-1:0]};

    wire [pWIDTH:0] reg_userio_clockout = {userio_clockout[pWIDTH-:pPLL_CLOCKS], {(9-pPLL_CLOCKS){1'b0}}};

    reg  [pWIDTH:0] userio_drive_data_reg;
    reg  [7:0] userio_drive_data_byte1;
    wire [pWIDTH:0] userio_drive_data;

    reg userio_fpga_debug;
    reg [7:0] reg_datao_reg;
    wire [7:0] reg_datao_drp;
    reg clksel;

    genvar i;

    generate
        for (i = 0; i < pWIDTH; i = i + 1) begin
            assign userio_d[i] = (bb_trig_select[3:0] == i) ? (bb_data_drive ? bb_data_out : 1'bz) :
                                 (bb_trig_select[7:4] == i) ? bb_clock_out :
                                 (~userio_cwdriven[i])?    1'bz : 
                                 (userio_fpga_debug)?      I_userio_debug_data[i] : 
                                 (reg_userio_clockout[i])? userio_clockgen[pWIDTH-i] : userio_drive_data[i];
        end
    endgenerate

    assign userio_clk = (bb_trig_select[3:0] == pWIDTH) ? (bb_data_drive ? bb_data_out : 1'bz) :
                        (bb_trig_select[7:4] == pWIDTH) ? bb_clock_out :
                        (~userio_cwdriven[pWIDTH])?    1'bz :
                        (userio_target_debug)?         FPGA_BONUS1 : 
                        (reg_userio_clockout[pWIDTH])? userio_clockgen[0] : userio_drive_data[8];

    `ifndef __ICARUS__
        PULLUP USERIO_D_PULLUP[pWIDTH-1:0] (.O(userio_d));
        PULLUP USERIO_C_PULLUP (.O(userio_clk));
    `endif

    // USERIO drive direction can be set via USERIO_CW_DRIVEN, but this gets
    // overwritten by userio_fpga_debug, userio_target_debug,
    // userio_target_debug_swd  and trace_en:
    assign userio_cwdriven = (trace_en)? {1'b0, trace_userio_dir} : 
                             (userio_fpga_debug)? {(pWIDTH+1){1'b1}} :
                             (userio_target_debug && userio_target_debug_swd)? (~(userio_clk)? 9'b0_0010_0000 : 9'b0_0110_0000 ) :
                             (userio_target_debug && ~userio_target_debug_swd)?  9'b0_1110_0000  :
                             reg_userio_cwdriven;

    wire [8:0] userio_read = {userio_clk, userio_d};

    assign userio_drive_data = (userio_target_debug)? {1'b0,        // USERIO_CK
                                                       target_MOSI, // carries TDI on USERIO_D7
                                                       target_PDID, // carries TMS/SWDIO on USERIO_D6
                                                       target_SCK,  // carries TCLK/SWDCLK on USERIO_D5
                                                       5'b0         // USERIO_D4:D0 undriven (TDO input on USERIO_D3)
                                                      } : userio_drive_data_reg;

    // register reads:
    always @(*) begin
        if (reg_read) begin
            case (reg_address)
                `USERIO_CONFIG:
                    case (reg_bytecnt)
                        0: reg_datao_reg = {6'b0, locked, clksel};                                                      // old USERIO_CLKSEL register
                        1: reg_datao_reg = {3'b0, userio_fpga_debug_select};                                            // old USERIO_DEBUG_SELECT register
                        2: reg_datao_reg = {5'b0, userio_target_debug_swd, userio_target_debug, userio_fpga_debug};     // old USERIO_DEBUG_DRIVEN register
                        3: reg_datao_reg = userio_cwdriven[7:0];                                                        // old USERIO_CW_DRIVEN register
                        4: reg_datao_reg = {7'b0, userio_cwdriven[8]};                                                  // ''
                        5: reg_datao_reg = reg_userio_clockout[7:0];                                                    // old USERIO_CLOCK_OUT register
                        6: reg_datao_reg = {7'b0, reg_userio_clockout[8]};                                              // ''
                        default: reg_datao_reg = 0;
                    endcase

                `USERIO_DRIVE_DATA:          reg_datao_reg = userio_read[reg_bytecnt*8 +: 8];
                default: reg_datao_reg = 0;
            endcase
        end
        else
            reg_datao_reg = 0;
    end

    assign reg_datao = reg_datao_reg | reg_datao_drp;
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
