newaetech/chipwhisperer-husky-fpga/(commit log)

2021-02-09 Clock cleanup: use clk_usb throughout.
    Also simplified some reset code.
    [clock_managment_advanced.v, openadc_interface.v, reg_chipwhisperer.v, reg_clockglitch.v, reg_openadc.v, reg_openadc_adcfifo.v, trigger_unit.v]
2021-02-09 Clock cleanup: make ADC clock out less confusing.
2021-02-10 Clean up phase update register (0x09)
    Setting "update" bit no longer necessary (but harmless for backwards
    compatibility).
    [clock_managment_advanced.v, reg_openadc.v]
2021-02-12 Create Husky top-level. Start constraints file.
    Replaced DCMs with MMCMs (except for the clock glitch ones).
    [clock_managment_advanced.v, cwhusky.xdc, cwhusky_top.v, openadc_interface.v, reg_chipwhisperer.v, reg_clockglitch.v, reg_openadc.v, reg_openadc_adcfifo.v]
2021-02-13 Replace USB register front-end with PhyWhisperer's
    Also, first bitfile - not validated yet.
    [cwhusky_tb.v, cwhusky_top.v, openadc_interface.v, reg_chipwhisperer.v, reg_clockglitch.v, reg_openadc.v, reg_openadc_adcfifo.v, tb_reg_tasks.v]
2021-02-17 Add ADC I/O, SAM3U post-config USART
2021-02-17 Add new FIFO.
    Bunch of features missing/untested, but it does have some life. Seems
    finicky on the FPGA itself, likely due to clock-domain crossing issues
    that will get addressed next.
    [adc_fast_fifo_sim_netlist.v, clock_managment_advanced.v, cwhusky.xdc, cwhusky_tb.v, cwhusky_top.v, fifo_top_husky.v]
2021-02-17 Fixed FIFO reset and some CDC logic around it.
    Seems to work consistently now.
    [cwhusky_tb.v, fifo_top_husky.v]
2021-02-18 ADC clock is alive!
    Drive ADC clock out and use the ADC supplied clock. Works!
2021-02-18 Add ADC programming capability.
    Simple bit-bang logic; works.
2021-02-19 Add ADC inputs.
    Miraculously seems to "just work", even without any timing constraints,
    even at 200 MHz! (using ADC's ramp pattern)
    Need to beef up FIFO logic to be able to record long traces and check
    for 100% accuracy, but it looks good.
    Some issues seen with resetting the FIFOs from the control register - it
    works in simulation, but not on the FPGA. However resetting the FIFOs
    from the re-arm event seems to work fine.
    [cwhusky.xdc, cwhusky_tb.v, cwhusky_top.v, fifo_top_husky.v, openadc_interface.v, reg_openadc.v]
2021-02-22 Add option to return 12-bit samples
    8-bit mode also supported. Capture is the same for both cases: the full
    12 bits are always recorded. The only difference is when reading the
    FIFO: in 8-bit mode, every FIFO read is one full sample, and in 12-bit
    mode, every FIFO read is 2/3 of a sample.
2021-02-23 Improve FIFO logic around resets.
    Xilinx FIFOs have strict requirements for no read/write activity
    during and after a reset. These changes should ensure these requirements
    are met in all conditions.
    To ensure this, the testbench is expanded to use three different ADC
    clock rates, and started a small regression suite.
    [cwhusky_tb.v, fifo_top_husky.v, regress.py]
2021-02-24 Add CLKGEN programmability.
    Not a full replacement for the S6 DCM yet, just direct R/W access to the
    MMCM configuration registers. Seems to work well, as long as you don't
    use fractional values, which are very badly documented (see XAPP888 and
    the reference DRP design if you wish to go down that road).
    For now, changed the default CLKGEN MMCM to *not* use fractional values.
    [clock_managment_advanced.v, cwhusky_tb.v, cwhusky_top.v, openadc_interface.v, reg_mmcm_drp.v, usb_reg_main.v]
2021-02-25 FIFO: start overhaul of control logic.
    Add FSM to consolidate most of the FIFO control logic in one place.
    Towards supporting presamples, segmenting, etc...
    Current test suite is still working, but there's still work to do.
2021-02-26 Testbench: fixed random seeding.
    Changed so that both Python and Verilog seeds are controlled, so that
    simulation runs can be reproduced.
    [regress.py]
2021-02-26 FIFO: capture only requested number of samples.
2021-02-26 Small fixes. Regressions now clean.
    1. Change "trigger now" so that we only act on it when we see it go from
    low to high, so that we don't repeatedly "trigger now". This is a change
    in behaviour from the CW-lite behaviour, but this feels like the correct
    way to do this.
    2. Stop writing the slow FIFO when capture is done.
    [cwhusky_tb.v, fifo_top_husky.v, regress.py, trigger_unit.v]
2021-02-27 FIFO fix to allow reading after writes are done.
    Verified on FPGA, seems to work well.
    Temporarily shrunk FIFOs and upsized ILAs to make debugging easier.
    [adc_fast_fifo_sim_netlist.v, cwhusky_tb.v, fifo_top_husky.v, regress.py, usb_slow_fifo_sim_netlist.v]
2021-02-27 Couple of FIFO bugfixes.
    Stop writing fast FIFO in "done" state; number of samples to capture
    includes number of presamples.
    [fifo_top_husky.v]
2021-02-27 Testbench: verify first sample value.
    Previously the first sample value was assumed good, and only subsequent
    values were verified. Now we peek at the ADC value when the trigger is
    issued, so we can verify that the first received value is correct
    (within some acceptable tolerance). Works with presamples too, *if* the
    FIFO is out of reset when the trigger occurs.
    [cwhusky_tb.v, regress.py]
2021-03-02 Add segmented capture.
    Some verification done, but likely some bugs remain.
    [cwhusky_tb.v, fifo_top_husky.v, openadc_interface.v, reg_openadc.v, regress.py, trigger_unit.v]
2021-03-02 Segments: fix bugs to allow for more than 2.
    [cwhusky_tb.v, fifo_top_husky.v, regress.py]
2021-03-02 Allow presamples in triggered segment mode.
    Also fixed some off-by-one errors to capture exactly the number of
    requested samples, and check that FIFOs are empty at the end (currently
    a warning if check fails, for captures that aren't a multiple of 3).
    [cwhusky_tb.v, fifo_top_husky.v, regress.py]
2021-03-02 FIFO management: ensure empty when done.
    Easier said than done due to the 3-sample wide slow FIFO. Solution is to
    capture extra samples to that the total number of captured samples is a
    multiple of 3 -- otherwise last 1 or 2 samples could end up "trapped" in
    the fast FIFO. Furthermore, we actually make the total number of
    captured samples be a multiple of 6 (not 3), otherwise it's messy on the
    slow FIFO read side (due to its 8-bit width). All this is under the hood
    and everything should work out as long as the host sets the capture (or
    segment) size to be a multiple of 6, and reads all that was captured.
2021-03-02 Add ALE line (USB_SPARE1).
    New bitfile with FIFO fixes from previous days.
    [cwhusky.xdc, cwhusky_tb.v, cwhusky_top.v, tb_reg_tasks.v, usb_reg_main.v]
2021-03-03 Testbench: tweak parameters.
    Tighten the first sample comparison window. Restrict presamples to be at
    least 8 (less than that causes FIFO to underflow). Increase minimum read
    delay.
    [cwhusky_tb.v, regress.py]
2021-03-03 Testbench: check first sample in low-res mode.
2021-03-04 Bunch of small FPGA improvements.
    - revert LEDs to their proper definition
    - make red LEDs flash quickly when something unexpected happens (so far:
    FIFO under/overflow; flashing stop when re-arming)
    - add a LED_SELECT control register to optionally show clock hearbeats on
    green/blue LEDs
    - remove unnecessary code from register blocks
    - have FIFO read back zeros when it's empty, to make it more clear to
    the user that they did something wrong
    [adc_fast_fifo_sim_netlist.v, cwhusky_top.v, fifo_top_husky.v, openadc_interface.v, reg_chipwhisperer.v, reg_husky_adc.v, reg_mmcm_drp.v, reg_openadc.v]
2021-03-04 ADC/external clock measurement logic.
    Made the existing logic more "proper". Also made it so the latest
    measurement is always what's read back. Verified using external clock,
    seems to work.
2021-03-11 Streaming support.
    Work in progress. Doesn't work consistently on FPGA. Likely due to using
    the USB control inputs directly.
    [adc_fast_fifo_sim_netlist.v, cwhusky.xdc, cwhusky_tb.v, cwhusky_top.v, fifo_top_husky.v, openadc_interface.v, reg_clockglitch.v]
2021-03-12 Fixed timing issues for streaming.
    Now works consistently, and no timing violations!
    [cwhusky.xdc, fifo_top_husky.v, reg_openadc_adcfifo.v, usb_reg_main.v]
2021-03-12 Fix streaming for full 12-bit samples.
    [fifo_top_husky.v, regress.py]
2021-03-13 Testbench improvements.
    Now covers longer captures. Added TINYFIFO option, which shrinks the
    sample storage from 128K to 4K, to more feasibly/quickly test streaming
    beyond the storage capacity, and exceeding the storage of the slow FIFO.
    Discovered a bug in segmented capture with presamples, which we'll have
    to get to later.
    [cwhusky_tb.v, fifo_top_husky.v, regress.py, tiny_adc_fast_fifo_sim_netlist.v, tiny_usb_slow_fifo_sim_netlist.v]
2021-03-13 Stop preventing fast FIFO overflow.
    This way, it will now get flagged as an error.
    [fifo_top_husky.v]
2021-03-13 Testbench: flag internal FIFO errors.
    [cwhusky_tb.v]
2021-03-17 Streaming: add indicator that data can be read.
    Goal is to have FW read only captured data, by waiting for indicator to
    go high. A new register sets how many samples must be available to read
    in order for the indicator to go high.
2021-03-28 Overhaul testbench sample reading and fix bugs.
    - Testbench now reads at the end of the capture only (unless streaming).
    - Fixed segments with presamples. Requires number of samples per segment
    to be a multiple of 3 (*not* enforced by design).
    - Number of segments is now actual number of segments, not +1 (i.e.
    pNUM_SEGMENTS=0 isn't valid).
    - Total number of samples stored is now a multiple of 3 (not 6).
    [cwhusky_tb.v, fifo_top_husky.v, reg_openadc.v, regress.py, tb_reg_tasks.v, trigger_unit.v]
2021-04-18 Add target UART and power on/off control.
2021-04-27 Fix for simulation with no XADC
    [cwhusky_top.v]
2021-04-27 Add FIFO error register.
    [cwhusky_tb.v, fifo_top_husky.v, openadc_interface.v, reg_openadc_adcfifo.v, regress.py]
2021-04-27 Add ADC clipping to FIFO error register.
    [fifo_top_husky.v, openadc_interface.v, reg_openadc.v, reg_openadc_adcfifo.v]
2021-05-06 Add missing debug file
    [slow_debug.v]
2021-05-11 Start tidying clock glitch logic
    [reg_chipwhisperer.v, reg_clockglitch.v, trigger_resync.v]
2021-05-11 Streaming tweak and restore full FIFO depth.
    Don't flag FIFO underflow error on stream reads once all samples have
    been read.
    [cwhusky_tb.v, cwhusky_top.v, fifo_top_husky.v, usb_slow_fifo_sim_netlist.v]
2021-05-18 Pick up some year-old Verilog updates.
    Somehow Husky missed these:
    a46ac824d99c65bbcab440b58182a76474cd3d9f
    b1e720b475594c49a62363c8659661edb2434806
    fb0ba7a22f9d39b988f00d92c20d501fa632cb15
    47edae5130f6febb157ca896482aa0aad2c9cb93
    [cwhusky_top.v, reg_chipwhisperer.v, reg_clockglitch.v]
2021-05-21 Clock glitching: swap S6 primitives for A7.
    Not functional yet, but compiles cleanly.
    [clockglitch_a7.v, cwhusky_top.v, reg_clockglitch.v]
2021-05-21 Add power down control for MMCMs.
    CLKGEN off by default. Otherwise things get toasty!
2021-05-25 Actually wire in the glitch clock.
    It took a few attempts to get this going: Vivado has some non-obvious
    rules regarding how MMCMs are allowed to be cascaded.
    [clockglitch_a7.v, cwhusky.xdc, cwhusky_tb.v, cwhusky_top.v, reg_clockglitch.v]
2021-05-27 Clock glitching: update phase shift logic for A7.
    [clock_managment_advanced.v, clockglitch_a7.v, mmcm_phaseshift_interface.v, reg_clockglitch.v]
2021-05-27 Clock glitching: add DRP control logic.
    For updating MMCM M/D parameters, in order to keep VCO frequency in
    range for different input frequencies.
    [clock_managment_advanced.v, clockglitch_a7.v, cwhusky_top.v, reg_chipwhisperer.v, reg_clockglitch.v, reg_husky_adc.v, reg_mmcm_drp.v, reg_openadc.v]
2021-06-01 Clock glitching: invert MMCM2 output instead.
    Follows documentation and makes more sense to me. Seems to work well in
    basic testing.
    [clockglitch_a7.v]
2021-06-03 Clock glitching: move register bits around.
    Retain more compatibility with non-Husky hardware, to minimize Python
    changes.
    [reg_clockglitch.v]
2021-06-03 Fix a testbench bug that had slipped in (segments)
    [cwhusky_tb.v]
2021-06-04 standardize copyright header, remove assembla links
2021-06-05 Linting; wire up the status register overflow bit.
    Also added 'lint' target to makefile.
2021-06-07 fix LEDs
2021-06-10 Make XADC errors sticky; write to clear.
    Found by chance that XADC alarms can be transient, so hold them in the
    status register until manually cleared.
    [xadc.v]
2021-06-11 Two tweaks: glitch source and default trigger.
    1. distinguish between clkgen and pll for the glitch source clock
    2. change default trigger to rising edge (so that
    scope.adc.trigger_count is 0 on power-up)
    [clockglitch_a7.v, cwhusky.xdc, cwhusky_top.v, reg_clockglitch.v, reg_openadc.v, trigger_unit.v]
2021-06-14 Add segmenting error, and bugfix.
    Previously, it was possible for a FIFO error flag to be reset by the
    occurence of another (different) error; now all errors are locked until
    cleared (re-arm or manual clear).
    [fifo_top_husky.v, openadc_interface.v, reg_openadc_adcfifo.v]
2021-06-16 Change stream_segment_size to ..._threshold
    (to avoid confusion; also use a sensible default setting)
    [cwhusky_tb.v, fifo_top_husky.v, openadc_interface.v, reg_openadc_adcfifo.v, regress.py]
2021-06-18 Count number of underflow reads.
    Also by default disable error flag on slow FIFO underflow, since SAM3U
    likes to read a multiple of 4 bytes on longer reads (even if instructed
    otherwise).
    [fifo_top_husky.v, openadc_interface.v, reg_openadc_adcfifo.v]
2021-06-23 Fix silly testbench bug
    [cwhusky_tb.v]
2021-06-23 Fix a couple of insidious segment/presample bugs.
    The current testbench didn't catch these because it only applies the
    trigger for a short time. But on a real target, where trigger is high
    for the duration of the capture, presample and/or segment errors would
    occur.
    [fifo_top_husky.v, trigger_unit.v]
2021-07-07 Add glitch observer code.
    [clockglitch_a7.v, cwhusky.xdc, cwhusky_tb.v, cwhusky_top.v, reg_clockglitch.v]
2021-07-09 Logic analyzer update.
    Moved to its own module and generalize (it's no longer just for glitch).
    [clockglitch_a7.v, cwhusky.xdc, cwhusky_top.v, openadc_interface.v, reg_clockglitch.v]
2021-07-12 Move MMCM reset to DRP logic.
    Makes more sense from Python POV since DRP is typically used to alter
    MMCM M/D settings, and these require an MMCM reset.
    [clock_managment_advanced.v, clockglitch_a7.v, reg_la.v, reg_mmcm_drp.v]
2021-07-22 Glitch: avoid extra glitches.
    Move the glitch go and count logic to the MMCM1 clock domain. This seems
    to be effective at avoiding extra glitches (at least as far as reg_la.v
    can see them -- which it did before these changes).
    [clockglitch_a7.v, cwhusky_top.v, fifo_top_husky.v, reg_clockglitch.v, reg_la.v, reg_openadc.v, reg_openadc_adcfifo.v, usb_reg_main.v]
2021-07-23 Add HS1 as an LA trigger source.
    (useful for testing CW-lite glitching using Husky)
    [reg_la.v]
2021-07-26 Prevent more double glitches when repeat=1.
    I think this completely eliminates the double glitch problem. Before I
    wasn't testing for them properly. Now I am and double glitches are no
    longer seen.
    [clockglitch_a7.v, cwhusky_tb.v, reg_clockglitch.v]
2021-07-29 Don't fire clip_error unecessarily.
    Only fire it on samples that are saved, not on presamples that will be
    discarded (by looking that the data entering the slow FIFO instead of
    the data entering the fast FIFO).
    Doesn't change much -- clipping is clipping, whether it's captured or
    not -- but this will avoid confusion.
    [fifo_top_husky.v]
2021-07-30 Add ADC in/out clocks to USERIO, for debugging
2021-07-30 Undo previous commit.
    Turns out that driving ADC clocks onto USERIO screws up timing badly,
    and in particular leads to really strange glitch behaviour.
    [cwhusky_top.v]
2021-08-05 Fix clip error logic (again).
    Because of clock domain issues, it could fire if the logical OR of
    successive samples was all 1's. Should be good and proper now. Also made
    the clip error sticky, so that you'll know it happened even if it didn't
    occur on your last capture (previously it was cleared by the next
    capture).
    [cwhusky_top.v, fifo_top_husky.v, reg_la.v]
2021-08-09 Add external clock frequency monitor and more.
    More: make LED flashing pattern less obnoxious; prevent glitch LED from
    turning on when glitching is disabled.
    [cwhusky_top.v, openadc_interface.v, reg_clockglitch.v, reg_openadc.v]
2021-08-10 Add ADC clip test function, to enable auto-gain.
2021-08-10 Add userio.v for programmable D<x> pin directions.
2021-08-12 Fix .xdc constraints file.
    No functional changes but Vivado implementation runs cleaner now.
    [cwhusky.xdc, cwhusky_top.v, openadc_interface.v, reg_clockglitch.v, reg_la.v]
2021-09-17 Copy FIFO simulation files.
    Vivado 2020.2 likes to encrypt these, which breaks iverilog simulation,
    so made a copy of the unencrypted ones. Disadvantage is that if FIFOs
    are modified in Vivado, changes won't be reflected in simulation, so
    beware!
    [adc_fast_fifo_sim_netlist.v, tiny_adc_fast_fifo_sim_netlist.v, tiny_usb_slow_fifo_sim_netlist.v, usb_slow_fifo_sim_netlist.v]
2021-10-04 Changed to slower -1 FPGA part.
    This made timing on USB_Data fail badly, so re-worked things to remove
    as much combo logic as possible in front of the output: registered FIFO
    read data and post-register-select read output. Add timing exceptions to
    make it work.
    [adc_fast_fifo_sim_netlist.v, cwhusky.xdc, cwhusky_top.v, fifo_top_husky.v, openadc_interface.v, reg_chipwhisperer.v, reg_clockglitch.v, reg_husky_adc.v]
2021-10-12 Switch to Linux path
2021-10-12 Two improvements for segmented captures.
    1. Detect a segment error that was missed before (occurs when the total
    number of samples exceeds what the slow FIFO can hold).
    2. "Capture done" status bit, which can be useful for SW to poll before
    attempting to read sample data, for long segmented captures. Otherwise,
    it's actually possible to underflow the FIFO by reading data faster than
    it's coming in.
    [fifo_top_husky.v, openadc_interface.v, reg_openadc_adcfifo.v]
2021-10-12 Re-enable slow FIFO underflow errors.
    Previously disabled because SAM3U can over-read; now, error is flagged
    only if 3 or more underflow reads occur in a capture, so that the
    over-reads don't trigger the error. This way, underflow due to user
    error gets flagged, which can be very helpful with segmented captures.
    [fifo_top_husky.v, reg_openadc_adcfifo.v]
2021-10-18 More diagnostics to chase intermittent bug.
    Some failures are seen from time to time with test_husky.py (not in
    simulation) when using segments with presamples. CDC issue is suspected?
    1. record the first error seen and the FIFO state when that first error
    occurs;
    2. send a bunch of trigger_unit.v signals to internal logic analyzer;
    3. add a new register to explicitly enable counter-based segmenting.
    [cwhusky_tb.v, cwhusky_top.v, fifo_top_husky.v, openadc_interface.v, reg_la.v, reg_openadc.v, reg_openadc_adcfifo.v, trigger_unit.v]
2021-10-19 Add progress bar to track passing tests.
2021-10-19 Cleanup in attempt to squash segment+presample bug
    Removed redundant CDC in FIFO reset, and gate trigger_unit issuing "go"
    on FIFO reset being done. Since bug is very intermittent it's hard to
    know if this eliminates it, but regardless, this fix is a good thing.
    [fifo_top_husky.v, openadc_interface.v, reg_openadc.v, trigger_unit.v]
2021-10-22 Add registers for max number of samples.
    There is a different maximum for segmenting, so this serves to make the
    limits clearer to the user.
    Also, new register indicates the max even after scope.adc.samples has
    been set.
2021-11-11 Automatically turn off all MMCMs upon XADC error.
    Also lowered the default temperature alarm settings:
    OT max temp = 90C
    user max temp = 80C
    [clock_managment_advanced.v, cwhusky_top.v, openadc_interface.v, reg_clockglitch.v, reg_la.v]
2021-12-10 Verify different offset values.
    Also fix related Verilog bugs.
    [cwhusky_tb.v, regress.py, trigger_unit.v]
2022-01-05 Fix off-by-1 bug in triggered segment capture.
    Should address https://github.com/newaetech/chipwhisperer/issues/380
    This shortens the latency on captured samples by one clock cycle.
    [trigger_unit.v]
2022-01-28 Add submodules for tracewhisperer
2022-01-28 Get trace working.
    One known issue: trace-clocked trace capture doesn't work because some
    IDELAY elements are needed on the trace port. Will get to that later.
    Target-clocked trace capture works just fine.
    [clock_managment_advanced.v, clockglitch_a7.v, cwhusky.xdc, cwhusky_tb.v, cwhusky_top.v, reg_chipwhisperer.v, reg_la.v, reg_mmcm_drp.v]
2022-01-28 Bring in segmenting bugfix from main.
    https://github.com/newaetech/cw_husky/commit/d6253d7c898ab37d373d50ddb84390ffeb5a3611
    [trigger_unit.v]
2022-02-01 Few updates and bugfixes.
    - add downsampling to LA
    - allow reading USERIO current state
    - fix bug on LA trigger source
    [cwhusky_tb.v, cwhusky_top.v, reg_chipwhisperer.v, reg_la.v]
2022-02-02 Move trace FIFO to cwhusky_top.v
    No functional change; towards sharing that FIFO with LA.
2022-02-08 Update LA storage to use shared FIFO with trace.
    This boosts LA storage depth to 16K!
    Requires selecting which block is active (LA or trace), and adding arming to
    LA.
    Also added downsampling (for e.g. slow UART captures).
2022-03-07 Use phywhisperer-common that's in tracewhisperer.
    Layers of submodules...
2022-03-07 TraceWhisperer update to simple_trigger.
    Also, proper CDC on the trace trigger.
2022-03-09 New trace features.
    Add 'capture off' mode and support for multiple trace-generated
    triggers.
2022-03-11 Allow UART triggering using TraceWhisperer.
    Also add XDC clock constraint, due to simple_trigger.v changes (was
    causing difficulty in meeting timing for scope.adc.trig_count).
2022-03-14 Trace: widen REG_SWO_BITRATE_DIV, +REG_BUFFER_SIZE
2022-03-15 Trace: Fix REG_BUFFER_SIZE, fix(?) UART bug.
    UART FSM would get sometimes stuck when running test_husky.py with new
    trace tests. UART input is now kept high when UART triggering or trace
    is disabled, which I think addresses the root cause; also added a
    mechanism to reset the UART FSM, just in case.
    [cwhusky_top.v]
2022-03-22 Add lo gain error.
    Improve logic around disabling/clearing lo gain and clip errors.
    [fifo_top_husky.v, openadc_interface.v, reg_openadc.v, reg_openadc_adcfifo.v]
2022-03-22 Testbench update missing from last commit.
    [cwhusky_tb.v]
2022-03-22 Add ADC-level based triggering.
    Note: limited to triggering only once after arming.
2022-03-28 Improve SAD trigger testing.
    Apply both positive and negative errors to make sure that sad.v is
    computing the sum of *absolute* differences!
    [regress.py, sad_tb.v]
2022-03-28 Improve SAD trigger testing.
    Make sure that we're pTHRESOLD_MARGIN above the trigger threshold when
    we're not intending to generate a trigger; if we can't achieve that,
    issue a warning.
    [sad_tb.v]
2022-03-28 SAD trigger: check for FIFO errors.
    [regress.py, sad.v, sad_tb.v]
2022-03-28 Add missing SAD FIFO simulation model.
    [sad_fifo_sim_netlist.v]
2022-03-28 Instantiate SAD module in Husky.
    Haven't tried implementing in Vivado yet... fingers crossed.
2022-03-29 SAD fixes: +active input; reset counters when done
    Successful implementation, works on FPGA, but large timing violations,
    quite far from 200 MHz target (~100 MHz).
    [cwhusky_top.v, openadc_interface.v, reg_chipwhisperer.v, sad.v, sad_tb.v, sad_wrapper.v]
2022-03-30 Try (and fail) to make sad.v fast enough.
    This area-optimized implementation just won't make 200 MHz, sadly.
    Keeping this work-in-progress for posterity in case it's useful
    elsewhere; see comments inside for more details.
    [sad.v]
2022-03-30 SAD triggering: speed-optimized version.
    Meets timing at 200 MHz!
    This implementation is 32 deep x 8 bits wide. Verified in simulation and
    on FPGA. Uses distributed RAM for 32 small FIFOs (one for each counter).
    64x8 implementation was succesful but bitfile behaved strangely:
    couldn't communicate with target and scope.XADC reported numbers that
    don't make sense (power draw too high?).
    [openadc_interface.v, sad.v, sad_tb.v, sad_wrapper.v]
2022-03-30 Failed SAD experiment.
    Explored using BRAMs to have a single wide FIFO.
    We have enough BRAM *bits* left to make it work, but BRAM FIFOs can't be
    > 72 bits wide, so 64x8 (and even 32x8) requires more BRAM *units* than
    what we have available. Unfortunately BRAMs aren't suited for wide and
    shallow FIFOs :-(
    [sad.v]
2022-03-30 SAD: revert to working implementation.
    Trimmed internal registers for 32x8.
    [regress.py, sad.v]
2022-03-31 SAD experiment: maximum single sample difference.
    Tested new feature where in addition to the SAD threshold, there is a
    "maximum deviation" parameter: if any single sample exceeds this
    threshold, a match event is prevented (that SAD counter is marked
    "dirty" until the offending sample has rolled out of the SAD counter).
    I wanted to see whether this could reduce the jitter observed across
    captures, but it doesn't seem to help. Kept the new code but it's
    disabled by a configuration parameter, in case it's useful later. Also
    note that it hasn't been fully tested.
    [sad.v]
2022-03-31 SAD: improvements and fixes.
    - bugfix: we were exiting the initialization phase too early, which made
    it possible to declare a trigger too early or one that shouldn't exist
    (e.g. if last reference samples didn't match).
    - new configuration register to control whether just one trigger is
    issued per arming, or possibly multiple triggers.
    - testbench: generate two triggers, to ensure we recover after the first.
    [sad.v, sad_tb.v]
2022-03-31 Add sad_fifo IP block.
    Missing from previous commits.
    [sad_fifo_sim_netlist.v]
2022-04-05 SAD: 2 bugfixes and testbench improvements
    These bugfixes eliminate the "jitter" that was seen on the FPGA. It
    wasn't actual jitter, it was bugs!
    Bug 1: each counter can only issue a trigger on one cycle every
    pREF_SAMPLES cycles! (doh!)
    Bug 2: account for internal latencies after flushing. This bug was
    causing SAD counters to effectively get an "offset" when
    re-initializing.
    Testbench: properly check multiple triggers, with or without flushing.
    [regress.py, sad.v, sad_fifo_sim_netlist.v, sad_tb.v]
2022-04-11 SAD and ADC triggering fix.
    Small but important change: don't trigger until armed *and* ready to
    capture, otherwise the single trigger can come and go before the capture
    is ready to start, and the capture times out even though there was a
    trigger.
    [cwhusky_top.v, openadc_interface.v, sad.v]
2022-04-14 Allow Husky to arm trace module.
    Avoids needing a separate scope.trace.arm_trace() call. Which is
    especially nice for UART triggering, where the concept of needing to arm
    the trace/UART module isn't very intuitive.
    [cwhusky.xdc, cwhusky_top.v, openadc_interface.v]
2022-04-25 SAD bugfixes.
    Don't trigger unless active; don't get stuck in FLUSH state; wait for
    armed_and_ready to go low before returning to IDLE. Before these fixes,
    SAD testing in test_husky.py often failed.
    [sad.v]
2022-04-26 Clean up trigger_resync.v
    Towards multiple programmable glitches.
    [reg_chipwhisperer.v, reg_clockglitch.v, trigger_resync.v]
2022-04-26 Fix trigger_resync bug; default to synchronous.
    Bug was introduced on last commit: trigger when offset exceeds lenght of
    incoming trigger signal.
    If you really want to sample the trigger asynchronously, define
    ASYNC_TRIGGER.
    [trigger_resync.v]
2022-04-27 Multiple programmable glitches.
    Seems to work well but not properly verified yet.
    [reg_clockglitch.v, trigger_resync.v]
2022-04-30 New glitch feature: multiple glitches.
    Instead of a single offset/repeat setting, you can now specify up to 32
    offset/repeats.
    [clockglitch_a7.v, cwhusky_tb.v, reg_clockglitch.v, regress.py, trigger_resync.v]
2022-04-30 Multiple glitches: fix NUM_GLITCHES meaning
    Represents number of glitches + 1, since 0 glitches doesn't make any
    sense.
    [cwhusky_tb.v, reg_clockglitch.v, regress.py, trigger_resync.v]
2022-05-02 Multiple glitches: tweaks to meet timing.
    Should be functionally identical.
    [clockglitch_a7.v, cwhusky.xdc, trigger_resync.v]
2022-05-02 Multiple glitches: improve testing.
    [cwhusky_tb.v]
2022-05-06 Multiple glitches: add a single glitch testcase.
    Corner case, to make sure trigger_resync FSM doesn't get stuck.
    [regress.py]
2022-05-06 Multiple glitches: lots of bug fixes.
    While ext_single was working ok, all the other modes got broken.
    [clockglitch_a7.v, cwhusky_top.v, reg_clockglitch.v, trigger_resync.v]
2022-05-09 RTL fix + tighten constraints.
    1. Fix empty_fifo_read clear condition: seemed to work fine in the
    PW-usb world, but here it could get stuck high.
    2. Register reads started to fail while building this (some data lines
    always reading as 0), so tightened the USB_Data constraints; works fine
    now.
    [cwhusky.xdc, cwhusky_top.v, reg_la.v]
2022-05-09 Add testcase for long programmable glitch offset.
    [regress.py]
2022-05-10 Important testbench fix.
    Don't wait for glitches when pTRIGGER_NOW, because they don't occur.
    [cwhusky_tb.v]
2022-05-10 Route Husky software reset to trace_top too.
    So that scope.reset_fpga() resets scope.trace too. Previously, a
    separate scope.trace.reset_fpga() was also needed.
    [cwhusky_top.v]
2022-05-16 WIP: meets timing, but test_husky.py failures
    Added BUFG to ADC input clock and relaxed ADC data constraints.
    Mysterious segmenting errors in internal_ramp tests (which do NOT use
    actual ADC sampled data!), but otherwise seems all fine. Needs
    investigation.
    [cwhusky.xdc, cwhusky_top.v, fifo_top_husky.v, openadc_interface.v, sad.v]
2022-05-16 Fix the bug causing issues in the last commit.
    Seems to work!
    [fifo_top_husky.v]
2022-05-17 Clean build (albeit with loosed ADC_DP constraint)
    Explored IDELAY on ADC_DP to help with hold violations but it makes
    timing issues pop up elsewhere in the design on observer_clock. Left if
    there around an `ifdef. Ran more testing on the bitfile, looks good.
    [cwhusky.xdc, cwhusky_top.v]
2022-05-19 Add testcases for short segments.
    [regress.py]
2022-05-25 Support target debugging with USERIO header.
    Using the side 20-pin connector, as described here:
    https://chipwhisperer.readthedocs.io/en/latest/debugging.html for
    CW-lite/pro, always worked; this allows using a standard ARM 20-pin
    cable on the front USERIO header instead.
    Doesn't support SWD mode yet (additional logic to deal with
    bidirectional SWDIO is needed).
    [cwhusky.xdc, cwhusky_tb.v, cwhusky_top.v, reg_chipwhisperer.v, userio.v]
2022-05-26 SWD target debugging.
    No bitfile yet because running into issues where basic register
    read/writes don't work consistently from build to build.
    [cwhusky_top.v, reg_chipwhisperer.v]
2022-05-26 Fix(?) FPGA read/write reliability issue.
    During target debugging work, started seeing bitfiles which failed basic
    register read/writes. The issue *seemed* to be with writing, since
    reading fpga_buildtime was always fine. But haven't been able to catch
    the problem live with ILAs (none of the bitfiles with ILAs exhibited the
    problem). Suspect the issue is WRT relative timing of the CEN and WRN
    signals, hence this fix, which *appears* to resolve the issue.
    [usb_reg_main.v]
2022-05-30 Make trig/glitch out MCX as labeled.
    Can be programmed to carry either trigger output or glitch output.
    [cwhusky.xdc, cwhusky_tb.v, cwhusky_top.v, reg_chipwhisperer.v]
2022-05-30 Fix downsample bug.
    Was introduced in the fifo_timing branch, looks like downsampling when
    the number of samples is one more than a multiple of 3. Would record one
    sample less than requested, so nothing disastrous. Regressed more
    intensively now and seems alright, hopefully timing can still be met.
    [fifo_top_husky.v]
2022-05-31 Downsample tweak.
    Since presamples aren't supported, start the downsample timer when the
    capture starts, so that repeated captures always get the same samples
    (before, the timer started upon arming).
2022-06-03 FIFO FSM: prevent getting stuck in DONE.
    If the FIFO isn't read (e.g. in a glitch campaign) and scope.adc.samples
    > what the slow FIFO can hold (96K samples), the FSM would get stuck in
    DONE. Now we exit DONE upon arming.
    [fifo_top_husky.v]
2022-06-06 Use AUX instead of HS1 as glitch source.
    (If that's what's specified by scope.clock.clkgen_src.)
    [cwhusky_top.v, reg_clockglitch.v]
2022-06-08 Possible partial fix for https://github.com/newaetech/chipwhisperer-husky-fpga/issues/4
    When scope.glitch.num_glitches is 1, don't count glitches before exiting
    the idle state. Can revert to the previous behaviour by writing 0 to
    address 111. This hasn't been verified to fix the issue, and it does
    nothing for the case where scope.glitch.num_glitches > 1.
    [clockglitch_a7.v, reg_clockglitch.v, trigger_resync.v]
2022-06-10 More tweaks towards fixing https://github.com/newaetech/chipwhisperer-husky-fpga/issues/4
    Move glitch done count to mmcm1 clock domain; route more signals for
    debugging to USERIO.
    [clockglitch_a7.v, cwhusky_top.v, reg_clockglitch.v, trigger_resync.v]
2022-06-13 WIP towards fixing glitch bug.
    [clockglitch_a7.v, cwhusky.xdc, cwhusky_tb.v, reg_clockglitch.v, trigger_resync.v]
2022-06-13 Cleanup changes from fixing glitch bug.
    Also extend incoming trigger by one cycle to ensure we don't miss it
    (since it's now clocked in by the phase-shifted mmcm1 clock).
    [clockglitch_a7.v, reg_clockglitch.v, trigger_resync.v]
2022-06-15 More glitch bug cleanup.
    - tweak signals going to LA to maintain same behaviour in
    husky_glitch.ipynb notebook
    - tweak Vivado synthesis and implementation strategies for better timing
    results in the ADC clock domain
    [cwhusky_top.v, reg_clockglitch.v]
2022-06-16 More glitch bug cleanup: fix LA problem.
    Last commit broke some of the test_husky.py tests due to CDC issues on
    the LA trigger signal used. Tricky one to fix since we want to be able
    to trigger capture in the source clock domain for husky_glitch.ipynb to
    have nice visuals. Seems to work!
    [cwhusky_top.v, reg_clockglitch.v, reg_la.v]
2022-06-21 Cleanup: remove CLKGEN and x1/x4 MMCMs
    Retain almost empty shell of clock_managment_advanced.v because,
    mysteriously, the fast FIFO empty flag doesn't behave properly (in
    simulation) otherwise.
    [clock_managment_advanced.v, cwhusky.xdc, cwhusky_top.v, openadc_interface.v, reg_clockglitch.v, reg_la.v, reg_openadc.v, sad.v]
2022-07-11 Trace: add ability to phase-shift trace clock.
2022-07-11 Fix low gain error logic.
    [fifo_top_husky.v]
2022-07-14 Fix bug around shared LA/trace MMCM input clock.
    Source MMCM input clock from trace block (i.e. whatever is specified as
    the trace clock). Measure that MMCM's input clock frequency to make it
    easier for Python to know the correct MMCM input frequency.
    [cwhusky.xdc, cwhusky_top.v, openadc_interface.v, reg_la.v]
2022-07-19 Check that all testbenches compile.
    SAD testbench was broken and didn't notice for awhile. With this change
    it will be caught right away next time.
    [regress.py]
2022-07-19 Fix SAD testbench.
    Testbench hadn't kept up with last few commits to sad.v.
    [sad_tb.v, sad_wrapper.v]
2022-07-20 Edge count trigger: add ASYNC_REG flops to input.
    On-target testing showed that without this, some edges were missed on
    TIO2 quite often. No missed edges observed with this fix.
    [edge_trigger.v]
2022-07-20 Add missing edge_trigger testbench files.
    Should have been added with 390d60f3c33916c90ada47cb7d4eed4f59a0eefe
    [edge_tb.v, edge_wrapper.v]
2022-07-23 LA: fix USERIO triggering (broken by last commit)
    [reg_la.v]
2022-07-24 Fix trace clocking.
    Clock IDDR with fe_clk to avoid inadvertent clock domain crossing.
    Simple fix for a bunch of weird issues!
    [cwhusky.xdc, cwhusky_top.v]
2022-08-02 Fix observer_clk target frequency.
    Likely broken by 656dc60b0cbb7b200e58e6736ef796f1985ae732. Commits since
    were targeting 96 MHz * 1.25 instead of 200 MHz * 1.25.
    [cwhusky.xdc]
2022-08-04 CW310: add missing xo_en and vddr controls
    [cwhusky_cw310_top.v, cwhusky_cw310_top.xdc, fifo_top_husky.v]
2022-08-04 CW310: slow down ADC FIFO reads.
    No changes for CW-Husky.
    On CW310 platform, SAM3U reads are slower, so we need to delay
    pre-fetching the next ADC read data byte (otherwise, the first byte of a
    burst read is missed).
    [reg_openadc_adcfifo.v]
2022-09-02 Add DDR R/W test module.
    Needed to disable LA to make Vivado happy with all our clocks. (There's
    surely a way to fix this without nixing the LA, but for the purposes of
    this experimental development, it's not worth the effort.)
    [cwhusky_cw310_top.v, cwhusky_cw310_top.xdc, cwhusky_top.v, fifo_top_husky_pro.v, openadc_interface.v, reg_openadc_adcfifo.v, setup.v, simple_ddr3_rwtest.v]
2022-09-09 DDR WIP.
    ADC data seems to be making it into DDR OK (simulation only); all that's
    left is the final FIFO output stage.
2022-09-12 DDR WIP: ADC data makes it all the way through.
2022-09-12 DDR WIP: get *all* of the ADC sample through.
    Cover the cases where the ADC samples don't finish on a 64-bit word
    boundary.
2022-09-13 Trying to fix the DDR writing->reading transition.
    [fifo_top_husky_pro.v]
2022-09-13 Remove logic which made # samples a multiple of 3.
    Husky needed this for its 36-bit (3-sample) wide FIFO, but here internal
    FIFOs are 64-bit wide and we store only the requested number of samples.
    Extra logic ensures that the last partial 64-bit word makes it through.
2022-09-13 Update FIFO errors to capture new FIFO errors.
    [cwhusky_pro_tb.v, fifo_top_husky_pro.v, openadc_interface.v, reg_openadc_adcfifo.v]
2022-09-13 More DDR write->read transition fixes.
    Should now correctly detect the last DDR write. Regressed over
    randomized capture sizes between 16 and 48 samples -- hopefully no
    corners remain.
    [cwhusky_pro_tb.v, fifo_top_husky_pro.v, regress.py]
2022-09-13 Fix linting for ddr3_app_model.v
    [ddr3_app_model.v]
2022-09-13 Keep ADC logic quiet when DDR self-test is running
2022-09-15 Fix app_addr incrementing on DDR reads.
    If app_rdy went away in the middle of our 2-cycle read, we would miss
    incrementing the address and end up issuing multiple reads for the same
    address.
    [fifo_top_husky_pro.v]
2022-09-16 Fix to avoid postddr FIFO overflow.
    Use the programmable threshold to stop DDR read requests before the FIFO
    is full (otherwise, responses will keep coming and overflow the FIFO).
    [fifo_top_husky_pro.v, post_ddr_slow_fifo_sim_netlist.v]
2022-09-19 Reset DDR FSM upon capture start.
    Ensures it doesn't get stuck when misused.
    [fifo_top_husky_pro.v]
2022-09-20 Add MMCM to optionally double the PLL_CLK1 clock.
    Allows testing at max 250 MHz ADC frequency on CW310 FPGA (ADC sampling
    clock is obtained from CW310 PLL which has a max of 167 MHz).
2022-09-20 Add option to bypass DDR.
    Works, but post-DDR FIFO overflows if capture exceeds its capacity, so
    some work remains.
2022-09-21 DDR bypass bugfix; WIP.
    Can now use the full capacity of the fast and post-DDR FIFO, but not the
    pre-DDR FIFO. If we exceed fast+post, the pre-DDR will overflow.
    [fifo_top_husky_pro.v]
2022-09-21 Bypass DDR fix.
    Can now use full FIFO space.
    [cwhusky_pro_tb.v, fifo_top_husky_pro.v, regress.py, tiny_post_ddr_slow_fifo_sim_netlist.v]
2022-09-22 More testing of edge cases with and w/o DDR.
    Fixed one more bug!
    [cwhusky_pro_tb.v, ddr3_app_model.v, fifo_top_husky_pro.v, regress.py]
2022-09-23 Move DDR logic to its own module.
    Cleaner and easier to add non-ADC sources.
2022-09-23 Add ability to issue a single DDR read or write.
    Using register interface, for validation/debugging.
    [cwhusky_pro_tb.v, ddr.v, openadc_interface.v, reg_openadc_adcfifo.v]
2022-09-26 Move post-DDR FIFO to ddr.v
    No functional changes. Just cleaner since DDR will store more than just
    ADC samples, and readback of everything it stores will be via the same
    common FIFO.
2022-09-26 Pare down the register address space.
    No functional changes. In anticipation of needing more register space
    for additional DDR options. We now have 27 register slots left. If more
    are needed, there are further trimming possible in LA and USERIO.
2022-09-27 Re-add logic analyzer.
    "Customized" clocking to get around implementation issues. Objective is
    to have multiple sources writing to DDR, not "proper" implementation.
    [cwhusky_cw310_top.xdc, reg_la.v, setup.v]
2022-09-28 Connect LA and trace to DDR.
    Not tested and almost certainly not functional, but ADC capture is not
    broken (yet).
    [cwhusky_cw310_top.v, cwhusky_top.v, ddr.v, fifo_top_husky_pro.v, openadc_interface.v, pre_ddr_generic_fifo_sim_netlist.v, preddr_18to64_converter.v, reg_la.v]
2022-09-29 WIP towards recording LA and trace data in DDR.
    A few fixes and added ramp test pattern to LA.
    9-bit word width makes it hard to see whether data is flowing
    correctly! But don't want to break compatibility with Husky.
    [cwhusky_cw310_top.v, cwhusky_pro_tb.v, ddr.v, openadc_interface.v, preddr_18to64_converter.v, reg_la.v, reg_openadc_adcfifo.v]
2022-09-29 Missing tracewhisperer update from last commit(s).
2022-10-03 Fix broken single DDR R/W.
    [cwhusky_pro_tb.v, ddr.v, openadc_interface.v, reg_openadc_adcfifo.v]
2022-10-04 Testbench: add --proc argument to regress.py
    Limit maximum number of parallel jobs: prevents computer from locking up
    and allows for more extensive regressions!
    [regress.py]
2022-10-06 Replace awkward FIFO reset mechanism.
    Now using a proper flush instead.
    [cwhusky_cw310_top.v, cwhusky_pro_tb.v, ddr.v, fifo_top_husky_pro.v, openadc_interface.v, preddr_18to64_converter.v, reg_openadc.v, trigger_unit.v]
2022-10-06 Make Husky compile again; FIFO reset/flush mods.
    Port same modifications done to Pro in
    2ffd82bb31ef9f28823cc2ca59ee0bb4bd3efea7.
    Simulations are clean, but not validated on FPGA yet.
    [cwhusky_tb.v, cwhusky_top.v, fifo_top_husky.v, fifo_top_husky_pro.v, openadc_interface.v]
2022-10-06 Fix LA+trace FIFO empty signaling.
    [cwhusky_cw310_top.v]
2022-10-07 Flush post-DDR FIFO prior to starting a read.
    Because the FIFO is first-word-fall-through, when doing multiple
    captures (e.g. ADC + trace) it's possible that one word is left in the
    FIFO. This fix automatically flushes the FIFO when a read is initiated.
    [cwhusky_pro_tb.v, ddr.v]
2022-10-11 Add "reading too soon error".
    To detect the case where the post-DDR FIFO is read before it was
    flushed.
    [ddr.v, fifo_top_husky_pro.v, openadc_interface.v, reg_openadc_adcfifo.v]
2022-10-11 DDR fixes.
    1. Fix 5e2bc2446f1665e03ab82f41e09fe39df280b5c1 to prevent firing
    underflow error at the end of the read phase.
    2. Exit active DDR read or write phase if we get a new arm pulse.
    [ddr.v]
2022-10-12 Fix LA/trace reads.
    As with ADC data, the DDR FSM needed to know when the read is finished
    (otherwise it just keeps reading!).
    [cwhusky_cw310_top.v, cwhusky_cw310_top.xdc, cwhusky_pro_tb.v, ddr.v, preddr_18to64_converter.v, reg_la.v]
2022-10-12 DDR: fix read_started -> first_read logic.
    Previously didn't work well if a flush was required at the start of the
    read operation.
    [ddr.v]
2022-10-13 Bugfixes to 9-bit read mode for LA/trace.
    Not extensively tested but seems to be working now.
    [preddr_18to64_converter.v]
2022-10-13 DDR FSM fix for aborted read.
    Handle the case where a read isn't completed (e.g. ADC read) and then
    another read is started (e.g. LA read).
    [ddr.v]
2022-10-14 DDR: extend some resets to non-ADC sources.
    A bunch of things got reset upon arming the scope, which did nothing
    when starting a trace or LA capture; they now get reset when the LA or
    trace start read command is issued.
    [ddr.v]
2022-10-16 Fix occasionally missing last write from LA/trace.
    Some issues appear to persist... occasional failures seen with on-target
    testing (never in simulation).
    [ddr.v, fifo_top_husky_pro.v, preddr_18to64_converter.v]
2022-10-17 Add comments to a known issue in ddr.v.
    Need a better testbench to confidently fix this.
    [ddr.v]
2022-10-18 Keep LA/trace pre-DDR outputs quiet when inactive.
2022-10-18 simple clock domain fix
    [ddr.v]
2022-10-21 Add basic ADC capture to cocotb.
    Not pretty but it's a start.
2022-11-02 Simplifying trigger clocking in trigger_resync.v.
    For glitching. No impact on glitch timing/latency when triggering from
    GPIOs. Can change timing on advanced triggers, but those weren't working
    properly anyways as per https://github.com/newaetech/chipwhisperer-husky-fpga/issues/6
    [cwhusky_top.v, reg_clockglitch.v, trigger_pulse_cdc.v, trigger_resync.v]
2022-11-03 Fix for https://github.com/newaetech/chipwhisperer-husky-fpga/issues/7
    Needs more testing but looks good.
    [reg_chipwhisperer.v, trigger_resync.v]
2022-11-04 Add more glitch trigger things to LA.
    To allow test_husky.py to validate fixes to
    https://github.com/newaetech/chipwhisperer-husky-fpga/issues/6 and
    https://github.com/newaetech/chipwhisperer-husky-fpga/issues/7
    [cwhusky_top.v, reg_la.v]
2022-11-04 Track job number in DUT top level.
    So it can be seen in waveform.
2022-11-05 Simplify and fix ADC sample reading.
    Realized that we're not restricted to short bursts here!
    [cw310_registers.py, test_husky.py]
2022-11-08 Cocotb: add locks to prevent concurrent read/write
    Still failing when enabling multiple sources. Could be a DUT bug?
    [cwhusky_cw310_cocowrapper.v, test_husky.py]
2022-11-08 Cocotb: log to file; check for errors only at end
    [test_husky.py]
2022-11-09 Cocotb: switch to global error counter.
    And add it to simulation waveform.
    [test_husky.py]
2022-11-09 Fix setting top DDR top address.
    It didn't work if other sources were active. First bug found by cocotb!
    [ddr.v]
2022-11-11 Cocotb: fix logging.
    Logging level best handled via COCOTB_LOG_LEVEL on make command line.
    [test_husky.py]
2022-11-11 Fix DDR arbitration bug.
    [ddr.v]
2022-11-11 Cocotb: fix test timeouts
    [test_husky.py]
2022-11-11 ADC capture bugfix.
    FIFO FSM would hang when arming if another source is active, because
    their FIFOs wouldn't go empty.
    [fifo_top_husky_pro.v]
2022-11-13 Cocotb: more internal error checking (FIFOs, DDR).
    [test_husky.py]
2022-11-14 Pad LA captures up to full 64-bit word.
    So that every captured sample gets pushed to DDR, instead of losing the
    last few stragglers when not a multiple of 64 bits.
2022-11-15 Detect post-DDR FIFO quasi-underflow.
    If a FIFO read results in an empty FIFO (*not* at the very end of the
    read), wrong data will be received since we're using the FIFO in
    first-word-fall-through. So this is now caught and flagged as an
    underflow. Probably quite unlikely to happen outside of simulation, but
    even so it's handy to save the debugging time.
    [ddr.v, ddr3_app_model.v, test_husky.py]
2022-11-15 DDR model tweak: hold up reads less frequently.
    To prevent underflows during reads.
    [ddr3_app_model.v]
2022-11-16 Flag more errors.
    - out-of-bounds DDR access
    - trace and LA pre-DDR FIFO over/underflow
    [cwhusky_cw310_top.v, ddr.v, fifo_top_husky_pro.v, openadc_interface.v, preddr_18to64_converter.v, reg_openadc_adcfifo.v, test_husky.py]
2022-11-16 Testbench: set ui_clk to its actual frequency.
    Help ensure there are no CDC issues (previously it just copied USB
    clock).
    [cwhusky_cw310_cocowrapper.v, cwhusky_cw310_top.v, cwhusky_pro_tb.v, ddr.v, openadc_interface.v, test_husky.py]
2022-11-17 Address some TODOs.
    Doesn't *seem* to have broken anything.
    [ddr.v, fifo_top_husky_pro.v, openadc_interface.v, preddr_18to64_converter.v, reg_openadc_adcfifo.v]
2022-11-17 LA in 9-bit capture mode.
    Minor design tweak to push all the samples through on the pre-ddr side.
2022-11-18 Add trace ramp test.
    Fixed a few bugs along the way. Seems to work well.
    [cwhusky_cw310_top.v, ddr.v, preddr_18to64_converter.v, reg_la.v, reg_openadc_adcfifo.v, test_husky.py]
2022-11-18 Cocotb: print seed
2022-11-22 Cocotb: allow one job to trigger another.
    E.g. ADC capture triggers LA capture. Some refinements needed but the
    bones are there.
2022-11-22 Cocotb: fix logging (silly typo).
    [test_husky.py]
2022-11-23 Cocotb: add find_bad_words()
    When bad samples are received, helps trace where things go wrong in the
    internal 32-bit datapath.
    [test_husky.py]
2022-11-24 Cocotb: allow ADC to trigger trace.
2022-12-02 Cocotb: ADC can trigger LA+trace simultaneously.
2022-12-05 Cocotb: split test_husky.py into 3 files.
    It was getting too large. Now:
    1. test_husky.py: testcases, harness
    2. test_husky_tests.py: test classes
    3. test_husky_captures.py: capture classes
    [test_husky.py, test_husky_captures.py, test_husky_tests.py]
2022-12-07 DDR: fix read kick-off logic.
    On larger captures that are not completely read, FSM was getting stuck
    because it would miss the pulse that kicks off the next read.
    [ddr.v]
2022-12-07 Cocotb: fix FIFO error monitoring.
    Turns out that RisingEdge() can't take boolean combinations of signals.
    [test_husky_tests.py]
2022-12-08 Fix USB interface initialization.
    It was working only by chance before!
    [cw310_registers.py, usb_reg_main.v]
2022-12-08 Cocotb: start of glitch testing (WIP).
    [cwhusky_cw310_cocowrapper.v, cwhusky_cw310_top.v, test_husky.py, test_husky_captures.py, test_husky_tests.py]
2022-12-09 Cocotb: improve glitch testing
    Cleanup; add repeat and offset.
    [cwhusky_cw310_cocowrapper.v, test_husky_captures.py, test_husky_tests.py]
2022-12-19 Bunch of cleanup.
    1. Make Husky compile again.
    2. Linting fixes.
    3. Facilitate simulating in different environments.
    4. Specify iverilog source files at the end of the iverilog command,
    otherwise fails on macOS.
    [cwhusky_top.v, fifo_top_husky.v, fifo_top_husky_pro.v, openadc_interface.v, preddr_18to64_converter.v, sad.v]
2023-01-30 Update tracewhisperer for UART triggering changes.
    Adds support for different word sizes and parity.
2023-01-31 Update tracewhisperer.
    UART improvements
    (https://github.com/newaetech/chipwhisperer-husky-fpga/issues/9)
2023-02-08 TraceWhisperer: UART parity error testing.
2023-02-14 SAD v3: trying new approach using fewer resources.
    Previous approach works but is very expensive in resources: it requires
    pBITS_PER_SAMPLE * pREF_SAMPLES^2 storage, so increasing pREF_SAMPLES is
    very expensive. This new approach doesn't use any FIFOs and storage is
    proportional to pBITS_PER_SAMPLE * pREF_SAMPLES so it should scale much
    more nicely. Not functional (yet), just a proof of concept for timing
    and area.
    [sad.v]
2023-02-16 SAD v3: allow for > 128 samples.
    Not validated, but at least now there is space to store SAD references
    longer than 128 samples.
2023-03-09 Fix merge issues and get CW310 Pro building again.
    [cwhusky_cw310_top.v, cwhusky_cw310_top.xdc, reg_la.v]
2023-03-09 Fix sad.v syntax oopsie.
    Looks like Vivado was doing the right thing but this is better.
    [sad.v]
2023-04-06 Fix for streaming with segments.
    Consider the total number of samples for stream_segment_available.
    [fifo_top_husky.v]
2023-04-18 New SAD module, sad_x2_slowclock.v
    Drop-in replacement for sad.v (except that it requires additional input
    clocks (half-rate), and the output trigger latency is higher). Trying
    this to get around the scaling limitations on pREF_SAMPLES; here we
    calculate two SADs per clock cycle (instead of one per), in a half-rate
    clock domain, which eases the critical paths seen with sad.v when
    cranking up pREF_SAMPLES.
    [adc_fast_fifo_semipro_sim_netlist.v, cwhusky_100.xdc, cwhusky_top.v, openadc_interface.v, regress.py, sad_tb.v, sad_wrapper.v, sad_x2_slowclock.v]
2023-04-19 New SAD module, sad_x2_slowclock.v
    WIP: works in simulation, but not on FPGA.
    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
    [cwhusky.xdc, cwhusky_top.v, openadc_interface.v, regress.py, sad_tb.v, sad_wrapper.v]
2023-04-20 FIFO errors: (hopefully) fix (potential) CDC issue
    Last build was starting to cause occasional presample errors in
    test_husky.py's frequency sweep test; most of the FIFO errors originate
    in the ADC clock domain but were being registered in the USB clock
    domain without concern for CDC. This changes the registering to the ADC
    clock domain, and appears to make the problem go away. Hopefully there
    are no unintended consequences.
    [fifo_top_husky.v]
2023-04-20 Prevent SAD triggers from being double-counted.
    e.g. scope.SAD.num_triggers_seen, when using sad_x2_slowclock.v
    [regress.py, sad_x2_slowclock.v]
2023-04-25 Add missing VARIANT make argument.
    [regress.py]
2023-04-27 XADC: shutdown SAD (in addition to MMCM) on error.
    Also keep things shutdown until the error flags are cleared by the user.
    [cwhusky_top.v, openadc_interface.v, sad.v, sad_wrapper.v, sad_x2_slowclock.v, xadc.v]
2023-05-05 Improve SAD.
    Removed a pipeline stage. Timing is still met and we get a substantial
    size reduction. Previously the area started exploding when pREF_SAMPLES
    went beyond 256. Now we can fit 512! Side benefit: latency is also
    reduced by 2 cycles.
2023-05-10 Increase LA/trace FIFO depth.
2023-05-10 Plus: fix MAX_SAMPLES and MAX_SEGMENT_SAMPLES
    [setup.v]
2023-05-17 Add PWM soft-power-on.
    Otherwise, turning power on the SAM4S target causes a VCCaux spike and
    alarm.
2023-05-18 Testbench: allow skipping tests based on variant.
    [regress.py]
2023-05-26 Fix CDC issues in fifo_top_husky_pro.v
    Some mirroring fixes done to fifo_top_husky.v in
    312c486a28c6e4adda1c46023596948c985e0c13; some particular to
    fifo_top_husky_pro.v. These have not been knowingly observed to cause
    problems but hopefully they were the cause of irregularities that
    occasionally popped up with on-FPGA testing? Time will tell.
    [fifo_top_husky_pro.v, openadc_interface.v]
2023-05-27 Cocotb: check first sample.
    For all captures (ADC/LA/trace), previously we assumed the first sample
    was correct and checked the rest of the capture by counting up from
    there; now the testbench peeks in to the design to see which is the
    first written value, and checks that that's what we get.
    [fifo_top_husky_pro.v, test_husky_captures.py]
2023-05-31 Cycle-based segments: cocotb support + bugfix
    [fifo_top_husky_pro.v, test_husky.py, test_husky_captures.py, test_husky_tests.py]
2023-06-02 Cocotb: add downsample for LA and ADC
2023-06-05 Cocotb: glitch ext_single testing
    [clockglitch_a7.v, test_husky_captures.py, test_husky_tests.py]
2023-06-06 Cocotb testbench fixes.
    Seems like augmenting glitch testing sniffed out some job scheduling
    bugs which hadn't come out before (of the type: new jobs triggered while
    setting up a job read, leading to it getting flushed out and
    deadlocked). This appears to fix it. Getting complicated but that's the
    cost of having simultaneous jobs in flight. Also: improved logging and
    timeouts.
    [cwhusky_cw310_cocowrapper.v, test_husky.py, test_husky_captures.py, test_husky_tests.py]
2023-06-20 Make ADC LED sticky and add clearing mechanism.
2023-06-23 Add option to invert the glitch/trigger MCX out.
    [reg_chipwhisperer.v]
2023-07-26 Allow SAD to always be active.
    Useful in the case of multiple SAD triggers, to know whether other SAD
    triggers occured after the ADC capture (e.g. because the threshold is
    too high).
    [sad_x2_slowclock.v]
2023-08-07 add missing files from last commit
    [trigger_chooser.v, trigger_sequencer.v]
2023-08-16 More debug + bugfix
    [cwhusky_top.v, reg_chipwhisperer.v, trigger_sequencer.v]
2023-08-18 Trigger sequencer: control when triggers can fire.
    e.g. only when it's a trigger's turn in the trigger sequence can it
    fire. Doesn't matter for basic triggers, but for things like edge count
    it's really important.
    [cwhusky_top.v, openadc_interface.v, reg_chipwhisperer.v, sad_x2_slowclock.v, trigger_chooser.v, trigger_sequencer.v]
2023-08-23 More trigger sequencer debug; userio tweak.
    USERIO: allow mixing non-CW-driven pins with FPGA debug output pins.
    (Useful for trigger sequencer debug when using trace.)
2023-08-24 Trigger sequencer: add missing testbench file.
    [trigger_sequencer_cocowrapper.v]
2023-08-31 Bugfix: don't let trigger seq counter overflow.
    [trigger_sequencer.v]
2023-09-01 Trigger sequencer usability improvements/fixes.
    - make trigger modules active only during their prescribed window; this
    is important to trigger modules like ADC that trigger only once (i.e.
    otherwise could fire once when it's its turn in the sequence, but before
    its window starts, which then prevents it from firing during the window
    even if its trigger condition is met)
    - optionally allow SAD module to ignore this; this can be helpful for
    tuning its window, so that you can see (on USERIO) where it's firing
    [reg_chipwhisperer.v, trigger_chooser.v, trigger_sequencer.v]
2023-09-01 Glitch tweak.
    When turning off glitch module, disable glitch *before* turning off the
    MMCMs to ensure that the glitch output doesn't remain asserted.
    [clockglitch_a7.v, reg_clockglitch.v]
2023-10-13 Address https://github.com/newaetech/chipwhisperer-husky-fpga/issues/17
    Changed usb_slow_fifo's write clock from 200 MHz to 96 MHz; seems to
    address the issue.
    Note that changing the FIFO type from built-in to BRAM may be the
    "proper" way to fix this, but leads to difficulties in timing closure
    (especially for the Plus, which needs 250 MHz). So we rely on extensive
    on-target testing to ensure this addresses the problem.
    [usb_slow_fifo_semipro_sim_netlist.v, usb_slow_fifo_sim_netlist.v]
2023-11-06 Register updates towards merging Pro/regular.
    Pro had a bunch of register address map changes
    (bce30bf71e9fff97b2f26963d8e654bf54d79df9); this basically applies them
    onto the develop branch, to ease the eventual merging Pro back into
    develop. Note that this will require Python-side updates too.
    Summary of changes:
    - DATA_SOURCE_SELECT: moved to FIFO_CONFIG (new register) (used for ADC test mode)
    - LA_STATUS: merged into read version of LA_ENABLED
    - EXTCLK_* merged into EXTCLK_MONITOR
    - disable_adc_error field (not present in Pro) must be moved to some
    - other register (from EXTCLK_MONITOR_DISABLED) -> let's move it to
    - ADCFREQ_ADDR, because it's related and not used for writes yet
    - CLIP_T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
2023-11-06 Fix?
    uncommitted 5-month old change :-/
    [test_husky_tests.py]
2023-11-09 Avoid resetting fifo_top_husky.v FIFOs.
    Port the flush mechanism used in fifo_top_husky_pro.v. Seems to work but
    still needs to be tested on-target.
    [fifo_top_husky.v]
2023-11-09 fifo_top_husky.v: fixes related to previous commit
    [fifo_top_husky.v]
2023-11-10 Add support for regular Husky to cocotb.
    WIP but most ADC tests are passing.
2023-11-13 Add missing "flushing" connection.
    [fifo_top_husky.v]
2023-11-13 oops missing from last commit
    [openadc_interface.v]
2023-11-13 fix huge_adc testcase for Husky
    [test_husky_captures.py, test_husky_tests.py]
2023-11-14 Husky: wire in trace and LA flushing signals.
2023-11-14 Husky trace testing.
    plus: fix flushing for trace and LA.
    [test_husky_captures.py]
2023-11-16 Husky: add test support for concurrent captures.
    Different from Pro because on Husky, trace and LA share storage and so
    can't be active at the same time.
2023-11-16 Husky test: more LA+trace exclusivity.
    Prevent them from both being downstream triggers from the same job.
    [test_husky_tests.py]
2023-11-16 another reg_la.v fix: recover from incomplete read
    again, unlikely IRL (a capture would have to be initiated while previous
    capture is still ongoing)
    [reg_la.v]
2023-11-16 testbench fix: ensure legal number of presamples
    [test_husky_tests.py]
2023-11-21 missing on last commit
    [cwhusky_cw310_top.v]
2023-11-21 cocotb: add ability to stream-read ADC samples
    (doesn't yet support concurrent captures; regular Husky only)
    [test_husky.py, test_husky_captures.py, test_husky_tests.py]
2023-11-22 Fix for overflow when streaming.
    One of the earlier commits (on the pro branch) broke this; the mechanism
    of the bug (specifically, why it worked before) isn't fully understood,
    but the symptom is that when a FIFO overflow occurs during a streaming
    capture, the SAM3U gets a bit messed up because the capture doesn't
    conclude as it should. The fix is that when a FIFO over/underflow error
    occurs during a stream capture, stream_segment_available is held high
    (regardless of FIFO contents), to ensure that SAM3U can finish reading.
    [fifo_top_husky.v]
2023-11-23 Detect "trigger too soon" error in hardware.
    This could happen if previous capture is not fully read; when the scope
    is next armed, the unread capture needs to be flushed, which is now done
    by reading the FIFO until it's empty (previously it was a FIFO reset but
    Xilinx FIFOs are picky about resets, hence the change). If there are a
    lot of unread samples, and the trigger comes very quickly after arming,
    then the system might not be ready to capture and the trigger would be
    missed. This error should flag that.
    [fifo_top_husky.v, fifo_top_husky_pro.v, openadc_interface.v, reg_openadc_adcfifo.v, test_husky_captures.py, test_husky_tests.py, trigger_unit.v]
2023-11-23 Tweak LED_ADC logic.
    Previously, it wouldn't indicate ADC unlock if the external clock
    monitor wasn't enabled.
2023-11-24 Cocotb: support streaming with concurrent capture.
    (e.g. ADC streaming with concurrent LA and/or trace capture)
2023-11-27 Cocotb: stop simulation on first error by default.
    [test_husky.py, test_husky_captures.py, test_husky_tests.py]
2023-11-28 Add 8-bit ADC mode support to Pro.
    As in Husky, internal storage is still 12 bits/sample; it's only the
    readback that's done at 8 bits/sample. So benefit is faster reading of
    samples.
2023-11-28 Cocotb: test 8-bit ADC mode.
2023-11-29 Cocotb: add glitch ext_continuous testing.
    [test_husky.py, test_husky_tests.py]
2023-11-29 Cocotb: print 1st error of failing testcases
2023-11-30 Cocotb: randomize trigger de-assertion time.
2023-11-30 Cocotb: directly use sampling clock when waiting.
    (when waiting for something related to # of samples, instead of
    converting to USB clock cycles)
    Makes IO4-triggered glitch job fail sometimes (expected glitch off by a
    cycle); will have to fix that.
    [test_husky_captures.py, test_husky_tests.py]
2023-11-30 Fix expected glitch time on IO4-triggered glitches
    [test_husky_captures.py]
2023-12-01 Cocotb: tweak glitch randomization parameters.
    [test_husky_tests.py]
2023-12-01 Cocotb: prevent missed glitch trigger.
    Glitch module captures the trigger using the glitch (currently USB)
    clock; when triggering from IO4, it was previously possible to miss the
    trigger if the ADC clock is faster than the USB clock.
    [test_husky.py, test_husky_tests.py]
2023-12-04 Cocotb: verify no glitch when not glitch testing.
    [test_husky.py]
2023-12-07 Cocotb: add missing return annotations.
    [cw310_registers.py, husky_registers.py, test_husky.py]
2024-01-12 Remove all unnecessary Vivado output files.
    :fingers-crossed:
2024-01-31 Fix testbench randomization/reproduceability.
    Affected Verilog testbenches (SAD, edge); broken in the move to cocotb.
    [regress.py]
2024-02-01 More SAD experiments: sad_x4_slowclock.v
    Use divided by 4 clocks and do 4 SADs per cycle.
    Doesn't seem to help for either regular or Pro configurations.
    [cwhusky_cw310_top.v, cwhusky_top.v, openadc_interface.v, sad_wrapper.v, sad_x4_slowclock.v]
2024-02-01 Test sad_x4; improve coverage for all SAD modules.
    Previously testbench only cared about the trigger rising edge and didn't
    check the trigger pulse width.
    [regress.py, sad_tb.v]
2024-02-01 SAD: Replace more magic numbers by a parameter.
    Functionally equivalent.
    [sad_x2_slowclock.v, sad_x4_slowclock.v]
2024-02-01 Fix sad_x4's reported latency.
    [sad_x4_slowclock.v]
2024-02-01 SAD: add per-sample comparison enable.
    WIP, but if it pans out, will add lots of flexibility over the current
    half/full pattern comparion option.
2024-02-06 Yet another SAD module, WIP.
    Promises to be significantly smaller, but some timing issues still need
    to get resolved.
    [openadc_interface.v, regress.py, sad_tb.v, sad_wrapper.v, sad_x2.v]
2024-02-07 sad_x2: add pipeline stage for better timing.
2024-02-07 sad_x2: allow length to not be a power of 2.
2024-02-09 SAD: allow more samples.
2024-03-25 Add ALWAYS_ARMED; timing improvement tweak.
    (Had missed adding this to this particular implementation when they were
    added to the other implementations.)
    [sad.v]
2024-03-27 SAD triggering: fix issues introduced by e5b6b499f5e94b14e147bc167617a491ee27e117
    1. Fix latency register.
    2. Don't overcount SAD triggers.
    [sad_tb.v, sad_x2_slowclock.v, sad_x4_slowclock.v]
2024-03-28 Add missing constraints for slow SAD clocks.
    [cwhusky.xdc, cwhusky_100.xdc, cwhusky_cw310_top.xdc]
2024-04-30 SAD cocotb (WIP).
    Address shortcomings of Verilog testbench (no more false errors), allow
    for different SAD models using a Python model that can also be used for
    on-target use.
    [husky_registers.py, regress.py, sad_wrapper.v, test_sad.py]
2024-05-01 SAD cocotb: missing file
    [sad_cocowrapper.v]
2024-05-01 SAD cocotb: fix simulating all implementations.
    Note: SAD_SINGLE, SAD_X4 can have failures.
    [esad.v, sad_single_counter.v, sad_wrapper.v, test_sad.py]
2024-05-02 esad bugfix
    Bug prevented triggering ~half the time!
    [esad.v]
2024-05-15 SAD: add test with longer reference; fix timeout.
    [regress.py, test_sad.py]
2024-05-15 SAD: fix the model's broken run() method
    For model use outside of Verilog regressions.
    [test_sad.py]
2024-06-24 sad_x4 verification fix for always_armed
    [sad_wrapper.v, sad_x4_slowclock.v]
2024-06-24 SAD timing improvements.
    Gets rid of the large mux selecting the reference sample for the first
    counter block. Since the reference sample selection is perfectly
    predictable, we can instead turn the array of flops that holds the
    reference samples into a large shift register, so that the first set of
    flops always contains the reference sample for the first counter block.
    Essentially free and gives significantly better implementation results.
    Only downside is that writing the reference samples isn't as
    straightforward. Not tested on-target yet, may need tweaking.
    Not implemented for sad_x2_slowclock.v or sad_x4_slowclock.v because
    (a) their additional clock domains would complicate things, an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
2024-06-28 SAD: fix version bits; add advanced trigger bit.
    [esad.v, sad.v, sad_single_counter.v, sad_x2.v, sad_x2_slowclock.v, sad_x4_slowclock.v]
2024-07-16 SAD WIP: trying to fix ref writing for real world.
    Previous writing mechanism doesn't work on-target because writes come in
    too fast for CDC. This is an attempt but doesn't fully work for not
    fully understood reasons. Lots of weirdness seen on-target, and size
    went up significantly so will likely abandon.
    [esad.v, husky_registers.py, sad.v, test_sad.py]
2024-07-19 SAD: fix ref writing!
    Finally works on-target, and implements nicely with the expected number
    of ref samples. The trick was to eliminate indexing into refsamples for
    writing, by using a FIFO. Makes writing a bit more fragile, and can no
    longer be read, but performs beautifully and allow for a nice increase
    in number of ref samples. May need some tweaks but appears to work quite
    well on-target.
    [esad.v, sad.v, test_sad.py]
2024-08-12 SAD: fix for when pREF_SAMPLES != a power of 2.
    (for the newer sad_base.v and esad.v versions)
    [esad.v, sad.v]
2024-08-13 SAD: fix writing SAD_REFEN for esad when emode=0
    [test_sad.py]
2024-08-13 SAD: provide means to exit armed_and_ready.
    After an unsuccessful capture, armed_and_ready remained high, which
    prevented SAD_REFERENCE/SAD_REFEN from being written.
    [esad.v, sad.v]
2024-10-01 SAD fix for trigger sequencer.
    Change the notion of "active" and add the notion of "trigger_allowed",
    to deal with the SAD module's relatively long startup time which could
    hurt usability in practice. Now, the SAD is kept running if it's part of
    a trigger sequence, and triggers are simply blocked if they don't occur
    during the window (marked by trigger_allowed).
    [cwhusky_top.v, esad.v, openadc_interface.v, reg_chipwhisperer.v, sad.v, sad_cocowrapper.v, sad_single_counter.v, sad_wrapper.v]
2024-12-03 Swap uart_core.v for uart_rx.v for better timing.
2024-12-05 Clean up Vivado files.
    Projects and associated IP blocks. Should be easier to build from a
    fresh check-out now :fingers-crossed:
2024-12-12 Update simulation for uart_core -> uart_rx change.
2024-12-16 Return 0 on measured clocks when clock is absent.
    Addresses https://github.com/newaetech/chipwhisperer-husky-fpga/issues/20
    [openadc_interface.v]
2025-05-27 USERIO: fix order of clocks.
    pll_out[0] -> USERIO CK,
    pll_out[1] -> USERIO D7,
    etc...
    [userio.v]
2025-05-27 USERIO: make CK pin driveable.
    Also make 9-bit drive data updates atomic.
2025-05-27 Option to mirror USERIO CK pin onto AUX I/O MCX.
2025-06-07 Fix timings in hw_bb_trig.v
    Wasn't counting quite right at the start (and end?) of patterns.
    [hw_bb_trig.v]
2025-06-07 Add simple testbench for hw_bb_trig.v
    Very simple, doesn't verify anything (yet), just a handy way to generate
    waveforms for different configs.
    [hw_bb_cocowrapper.v, hw_bb_wrapper.v, test_hw_bb.py]
2025-06-09 hw_bb_trig.v clocking fixes.
    - make clk_div do what it says (before it was off by a factor of 2)
    - prevent sampling from occuring before driving: sampling happens either
    at the same time as driving, or half a cycle later
    [hw_bb_trig.v]
2025-06-19 Wire-in hw_bb_trig's trigger output properly.
2025-07-16 Change priority of userio pin drivers.
    Make hw_bb_trig.v #1.
2025-09-15 BB: add option for glitch to drive 0, 1 or invert.
    [hw_bb_trig.v]
2025-10-02 BB: fix data recording timing.
    [hw_bb_trig.v]
2025-10-02 BB: fix clock output timing
    [hw_bb_trig.v]
2025-10-03 BB: edge-case fixes
2025-10-30 BB: more error checking
    Previously, FIFO underflow conditions would effectively be masked; this
    should catch them.
    [hw_bb_trig.v, test_hw_bb.py]
2025-10-31 BB: add target_pwr, nrst to data_pin options.
    However they behave differently from the other BB data pins: a '1' in
    the pattern *inverts* their state (0 leaves it unchanged).
    [reg_chipwhisperer.v]
2025-10-31 Fix soft-power-on PWM logic.
    Two fixes:
    1. Previously, PWM logic flag would remain active, which would prevent
    bit-banger from inverting the target power line.
    2. The second set of PWM parameters didn't work as intended; this should
    be fixed now.
    [reg_chipwhisperer.v]
2025-11-20 ILA fixes
    for debug only; inconsequential for production bitfile
    [fifo_top_husky.v]
2025-11-20 Reset changes.
    Remove RESET register and have SETTINGS_ADDR-driven reset work properly.
    To address https://github.com/newaetech/chipwhisperer-husky-fpga/issues/23
    [reg_openadc.v, test_husky.py]
2025-11-27 Update Verilog testbench for reset change.
    [cwhusky_tb.v]
2026-01-27 Candidate fix for https://github.com/newaetech/chipwhisperer-husky-fpga/issues/24
    Needs further validation but looks good.
    Bug fix is a single line change; the rest of changes in this commit are
    additions to make it easier to know whether glitches have been
    generated.
    This changes the behaviour of reading the CLOCKGLITCH_NUM_GLITCHES
    register (scope.glitch.actual_num_glitches), but that was previously
    useful only for debugging a situation that should not occur.
    [reg_clockglitch.v]
2026-02-03 BB: add option to restrict to USERIO pins.
    Defining BB_LIMIT prevents BB from using TIO, nRST, and target power
    pins. This helps meet timing for Husky.
    [reg_chipwhisperer.v]
2026-02-03 Reduce observer_clk from 1.25x to 1.2x of max ADC.
    This helps meet timing more consistently and doesn't violate any
    published specs.
    [reg_la.v]
2026-02-03 Vivado: add missing async clock to group.
    [cwhusky.xdc, cwhusky_100.xdc]
2026-02-17 Change Husky Plus synthesis strategy.
    Previous one met timing but led to very high utilization, which caused
    voltage supply issues at high clock frequencies. With this change,
    timing is still met and the implemented design is significantly smaller.
2026-03-19 BB: towards adding I2C support, WIP
    - add per-cycle clk_en
    - add clock_inactive_state
    - fix potential setup issues by driving data a quarter cycle ahead of
    its clock edge
    Seems to work pretty well but not all of this is properly tested yet.
    [husky_registers.py, hw_bb_cocowrapper.v, hw_bb_trig.v, hw_bb_wrapper.v, test_hw_bb.py]
2026-04-15 Trying a totally different ADC FIFO architecture.
    Goal is to really minimize the fast-clock storage, without defeaturing
    (e.g. without reducing presamples). WIP.
2026-04-24 New FIFO still WIP; presamples working well.
    Trickier than expected! Note this entails changes on Python side for how
    many samples need to be read, and to fetch the starting sample's offset
    at the end. More work required to support segmented capture.
2026-04-29 New FIFO: fixes for no or few presamples.
    [fifo_top_husky.v]
2026-04-29 New FIFO: fixes for large captures.
    [fifo_top_husky.v, slow_fifo_wrapper.v]
2026-05-01 New FIFO: +downsampling; fix segments w/o presamps
    [fifo_top_husky.v, test_husky_captures.py]
2026-05-04 New FIFO: streaming fix.
    Almost missed the one place where the new architecture makes things
    easier! No more CDC required to figure out whether there is a segment
    available to be read.
    [fifo_top_husky.v]
2026-05-09 Rebuild Husky Plus bitfile with better constraints.
    Should fix potential timing issues when writing data.
    [cwhusky_100.xdc]
2026-05-13 timing improvement; prevent latches
    [hw_bb_trig.v, reg_mmcm_drp.v, userio.v]
2026-05-13 Testbench fixes.
    1. give stream_segment_available time to get updated
    2. work around weird cocotb bug(?) where ALEn sometimes does not get asserted
    [husky_registers.py, test_husky_captures.py]
2026-05-14 Testbench fix.
    Adjust expected glitch timing due to change in register write timing.
    [test_husky_captures.py]
2026-05-14 Testbench fixes. Clean full regressions!
    When reading ADC samples in fast mode, lock out other threads from
    reading/writing registers.
    [husky_registers.py, test_husky.py, test_husky_captures.py]
2026-06-01 New FIFO updates: segmenting fixes
    Lots of fixes around "fast fifo empty", which is tricky to get right,
    and has different meanings in different clock domains.
    Also promoted the "incorrect offset word" from a warning to an error
    since it should never happen, and regressions are running very cleanly
    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
    [fast_fifo_wrapper.v, fifo_top_husky.v, regress.py, test_husky_captures.py, test_husky_tests.py]
2026-06-02 Remove downsample error flag.
    No reason to waste FPGA logic on this- software can flag it.
    [fifo_top_husky.v, test_husky_tests.py]
2026-06-02 New FIFO: re-write clip detection logic.
    Note that it's moved from the ADC to the USB clock domain.
2026-06-15 New FIFO: bugfixes
    Still WIP but getting closer; works on-target.
    [cwhusky_fifoonly.v, fast_fifo_wrapper.v, fifo_top_husky.v, slow_fifo_wrapper.v]
2026-06-16 New FIFO tweaks.
    - change offset pattern to something that wouldn't happen when ADC is
    clipping
    - don't set off clip errors from offset word
    [fifo_top_husky.v, test_husky_captures.py]
2026-06-18 New FIFO: fix lo_gain error logic.
    Tricky to get right but this should finally do it!
    [fifo_top_husky.v]
2026-06-19 New FIFO: tweak FIFO reading logic.
    Avoids the "reading and writing same BRAM address" that had started
    popping up. Basically: don't read almost-empty FIFO unless we know it's
    no longer being written. Tricky but this should take care of it.
    [fast_fifo_wrapper.v, fifo_top_husky.v, slow_fifo_wrapper.v]
2026-06-19 New FIFO: fix stream_segment_available.
    [fifo_top_husky.v, slow_fifo_wrapper.v]
2026-06-23 Testbench: print seed at the end of the test.
    (because $display'd warnings from FIFO models can overwrite the first
    lines of the logfile)
2026-06-23 Testbench: favor extreme ADC clock frequencies.
2026-06-23 Make FIFO over/underflow errors clearable.
    (previously they only got cleared upon arming)
    [fifo_top_husky.v, fifo_top_husky_pro.v]
2026-06-29 New FIFO: increase internal FIFO width to 72.
    It needs to be a multiple of 36 for maximum BRAM utilization.
    Without this change we'd have less sample space than before; now we'll
    have more (because original architecture wasn't 100% efficient in its
    BRAM usage; this change brings us much closer to 100% BRAM usage efficiency).
    Functional but some bugs remain.
    [fast_fifo_wrapper.v, fifo_top_husky.v, slow_fifo_wrapper.v, test_husky_captures.py, test_husky_tests.py]
2026-07-09 New FIFO testing: add large ADC capture tests.
2026-07-23 New FIFO: resolve segments + presamples error.
    Annoying error which would only occasionally manifest on-target (see
    notes in fifo_top_husky.v for details).
    Also expanding FIFO_FIRST_ERROR to capture counter values when the first
    error occurs.
    [fast_fifo_wrapper.v, fifo_top_husky.v, openadc_interface.v, reg_openadc_adcfifo.v]
2026-07-23 New FIFO: minor testbench tweaks.
    Presamples test fix, and new mechanism to deal with very small captures
    with presamples.
    [regress.py, test_husky_captures.py, test_husky_tests.py]
2026-07-24 New FIFO simulation: tweak max presamples
    Bit trial-and-error due to multiple FIFOs, CDC, etc...
    [regress.py]
2026-08-10 Better fix for https://github.com/newaetech/chipwhisperer-husky-fpga/issues/28
    Simplify, remove, and fix some resets which seemed to contribute to the
    bug; drive reset_arm from capture_active_o's assertion, instead of from
    the async trigger.
    Appears to be solid and should withstand routing delay differences on
    the trigger line exceeding one clock cycle (which previous fix would
    not).
    Short of adding sync stages to the async trigger input line (which would
    increase triggering latency), I think this is the best we can do.
    [trigger_unit.v]
2026-08-13 New FIFO: address offset saving bug.
    New bug popped up during on-target testing: on a non-segmented capture
    where the trigger fires multiple times during the capture, the
    additional firings cause the initial (and good) segment offset to get
    clobbered (always with the value of 1, BTW, due to how the counter
    works).
    (This bug is a product of the new architecture and hasn't existed in the
    wild.)
    [fifo_top_husky.v]
2026-08-19 New FIFO: multiple improvements and bug fixes
    - add flushing to the presample FIFO
    - make fast_fifo_wrapper's empty flag mechanism more simple,
    conservative, and tuneable: while it worked fine for the regular Husky
    configuration, Plus's deeper FIFO (and faster speed?) could cause
    misbehaviour at certain clock speeds
    - add more USERIO debugging options
    - detect if save_offset_usb happens too late
    [cwhusky_fifoonly.v, cwhusky_top.v, fast_fifo_wrapper.v, fifo_top_husky.v, openadc_interface.v, reg_openadc_adcfifo.v]
2026-08-27 Docs: add high-level ADC architecture
    High-level documentation of the changes on
    1d7fc4a4d27574ea2ae7b61d5fefc6980b27fdf7 (the plus_optimization branch
    work).
2026-09-10 BB: debug-only changes
    Instantiate all 4 combos of drive_edge and clock_inactive_state, to make
    it easier to fix the timing for the starting and stopping of the clock
    for each case.
    [hw_bb_trig.v, hw_bb_wrapper.v]
2026-09-10 BB: missing change from last commit
    [hw_bb_wrapper.v]
2026-09-14 BB: fix clock_inactive_state behaviour and testing
    Mostly around the odd case when drive_edge = clock_inactive_state, where
    we've decided to essentially not have a clock edge for the first bit.
    Also improved testing to not rely on the output clock edges as much as
    possible, but instead use the ADC clock and clk_div.
    Regresses cleanly but not tested on-target yet.
    [hw_bb_trig.v, test_hw_bb.py]
2026-10-14 Testbench improvements.
    Around untriggering. Previously there were (inadvertently) two parallel
    untriggering threads in some cases. Adjusted untriggering times.
2026-10-16 Tracewhisperer update (just a comment).
